POTOK22/STM32-PLC/Documentation/WEBENCH/15Vto5V/WBBOMDesignTPS563200DDCR.csv

Part | Manufacturer | Part Number | Quantity | Price ($) | Footprint (mm²) | Description
Rfbt | Yageo | AC0402FR-0756K2L | 1 | 0.01 | 3 | Resistance: 56.2 kΩ Tolerance: 1.0% Power: 63 mW
Cout | MuRata | GRM21BR61A226ME44L | 2 | 0.09 | 6.75 | Cap: 22 µF Total Derated Cap: 20 µF VDC: 10 V ESR: 3 mΩ Package: 0805
L1 | TDK | VLP8040T-3R3N | 1 | 0.22 | 113.42 | L: 3.3 µH DCR: 20 mΩ IDC: 5.2 A
Rfbb | Vishay-Dale | CRCW040210K0FKED | 1 | 0.01 | 3 | Resistance: 10 kΩ Tolerance: 1.0% Power: 63 mW
Cin | Taiyo Yuden | MSAST219LB5106KTNA01 | 2 | 0.09498 | 6.75 | Cap: 10 µF Total Derated Cap: 2.9 µF VDC: 25 V ESR: 5.85 mΩ Package: 0805
U1 | Texas Instruments | TPS563200DDCR | 1 | 0.342 | 14.82
Cbst | AVX | 08053C104KAT2A | 1 | 0.01 | 6.75 | Cap: 100 nF Total Derated Cap: 100 nF VDC: 25 V ESR: 280 mΩ Package: 0805
