POTOK22/STM32-PLC/Documentation/LTspiceSims/AnalogInSim/analog_input.asc

C1: cap; 100n
D1: zener; EDZV11B
D2: zener; BZX84C6V2L
R1: res; 100k
R2: res; 1k
R3: res; 20.5k
R4: res; 10k
R5: res; 20.5k
R6: res; 10k
U2: LM308
V1: voltage; SINE(0 10 40)
V2: voltage; -15
V3: voltage; 15
V4: voltage; 3.3
Named nets: 0, OUT, IN
.tran 1 startup
