POTOK22/STM32-PLC/Documentation/LTspiceSims/AnalogOutSim/analog_output.asc

C1: cap; 100n
C2: cap; 100n
C3: cap; 100n
C4: cap; 100n
C5: cap; 100n
R1: res; 100k
R2: res; 1k
R3: res; 33k
R4: res; 470
R5: res; 15.4k
R6: res; 10k
U1: LM308
U2: LM308
V1: voltage; SINE(2.465 0.825 40)
V2: voltage; -12
V3: voltage; 12
V4: voltage; 12
V5: voltage; -12
V6: voltage; 5
V7: voltage; SINE(0.825 0.825 40)
Named nets: 0, OUT, IN
.tran 1 startup
