POTOK22/STM32-PLC/Documentation/LTspiceSims/DigitalInSim/digital_input.asc

C1: cap; 1n
C2: cap; 470p
D1: schottky; PMEG3005AEA
D2: LED; NSCW100
M1: pmos; Si7137DP
R1: res; 47k
R2: res; 1k
R3: res; 1k
R4: res; 270k
R5: res; 47k
U1: CNY17-1
V1: voltage; PULSE(0 24 10ms 0.5ms 0.5ms 5ms 10ms)
V2: voltage; 3.3
Named nets: 0, IN, OUT
.tran 100ms startup
