POTOK22/STM32-PLC/Documentation/LTspiceSims/DigitalOutSim/digital_output.asc

D1: LED; NSCW100
M1: nmos; Si7336ADP
R1: res; 1k
R2: res; 1k
R3: res; 47k
R4: res; 220
U1: CNY17-1
V1: voltage; PULSE(0 3.3 10ms 0.5ms 0.5ms 5ms 10ms)
V2: voltage; 3.3
V3: voltage; 24
Named nets: 0, OUT, IN
.tran 100ms startup
