POTOK22/STM32-PLC/Hardware/AnalogIO/analogIO.kicad_pcb

## KiCad design Hardware/AnalogIO/analogIO.kicad_pcb (2026-01-13)

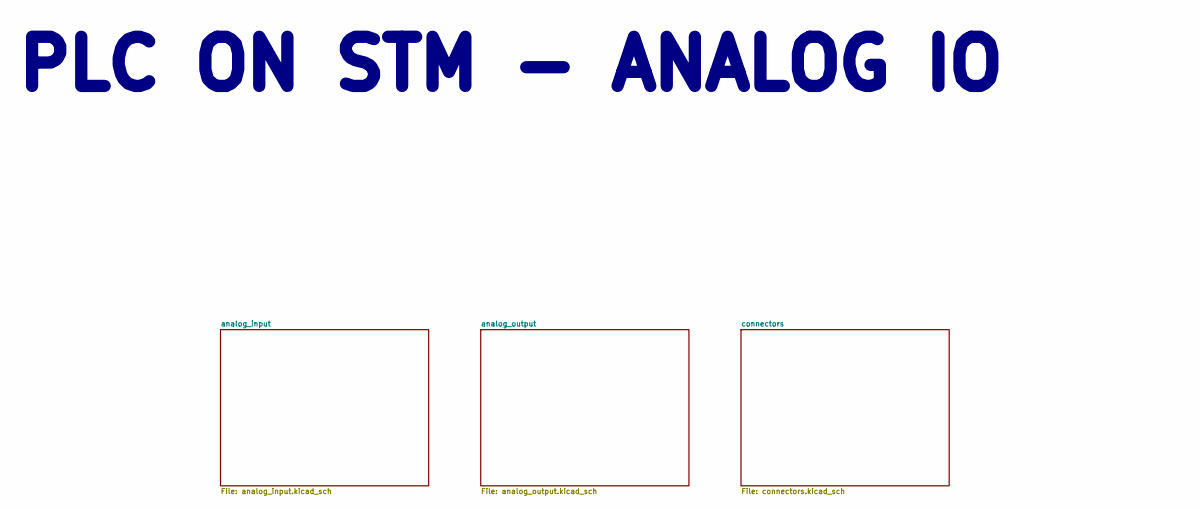
[picture p1: schematic analogIO.kicad_sch, PLC on STM - Analog IO Shield]

Notes on the sheet:
PLC ON STM - ANALOG IO

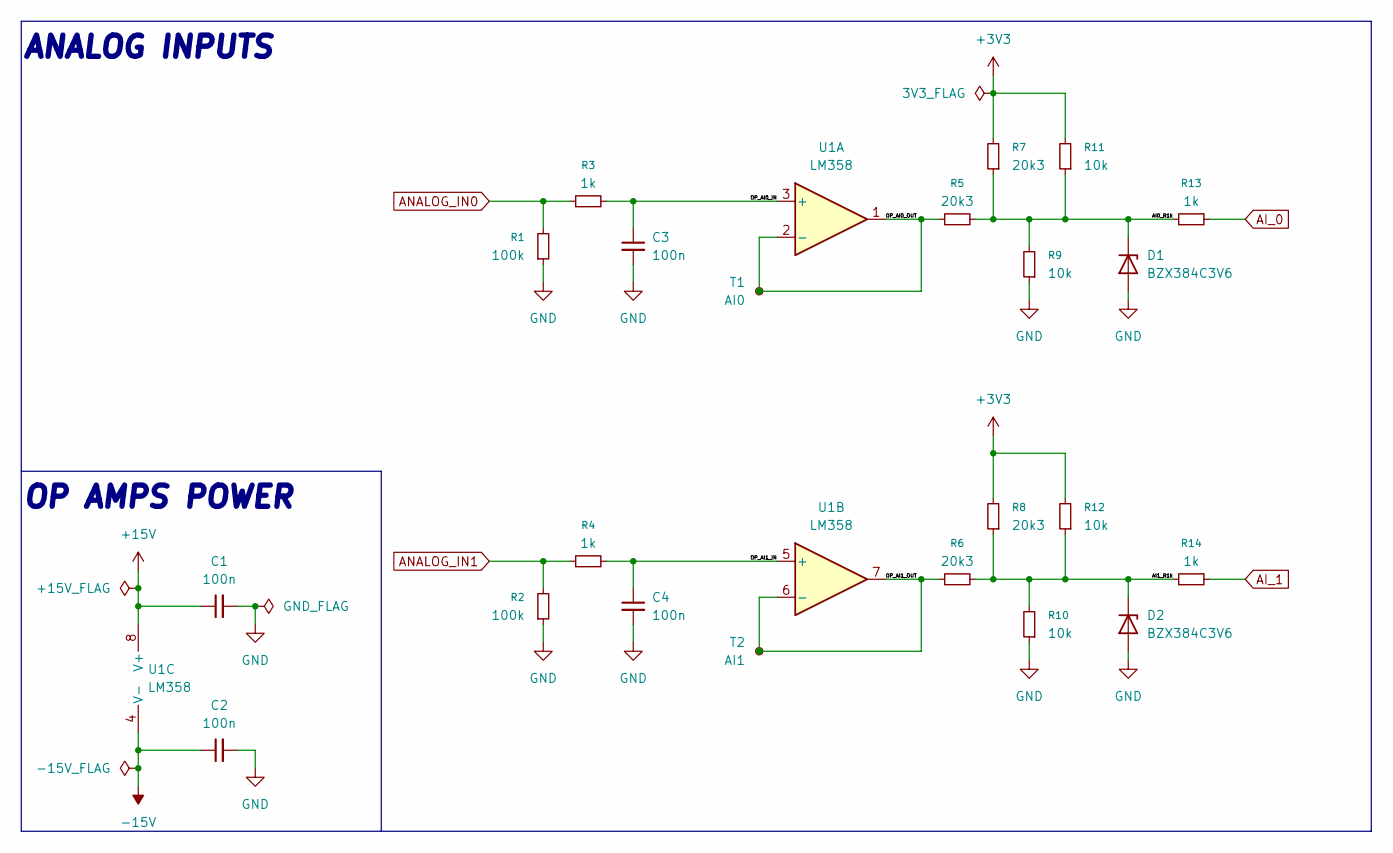
[picture p2: schematic analog_input.kicad_sch, PLC on STM - Analog IO Shield]

Parts:
C1, C2, C3, C4: 100n; C_0603_1608Metric_Pad1.08x0.95mm_HandSolder; Mouser Part Number GRM033R6YA104ME14D
D1, D2: BZX384C3V6; D_SOD-323; Mouser Part Number 78-BZX384C3V6-HE3-08
R1, R2: 100k; R_0603_1608Metric_Pad0.98x0.95mm_HandSolder; Mouser Part Number 603-RT0603DRE07100KL
R3, R4, R13, R14: 1k; R_0603_1608Metric_Pad0.98x0.95mm_HandSolder; Mouser Part Number 71-CRCW06031K00FKED
R5, R6, R7, R8: 20k3; R_0603_1608Metric_Pad0.98x0.95mm_HandSolder; Mouser Part Number 71-CRCW0603-20.5K-E3
R9, R10, R11, R12: 10k; R_0603_1608Metric_Pad0.98x0.95mm_HandSolder; Mouser Part Number 71-CRCW0603-10K-E3
T1: AI0; TestPoint_Pad_1.0x1.0mm
T2: AI1; TestPoint_Pad_1.0x1.0mm
U1: LM358; SOIC-8_3.9x4.9mm_P1.27mm; Mouser Part Number 511-LM358D

Connections:
+3V3: R7.2, R8.2, R11.2, R12.2; also elsewhere on the board
+15V: C1.1, U1.8 (V+); also elsewhere on the board
-15V: C2.1, U1.4 (V-); also elsewhere on the board
/analog_input/AI0_R1k: D1.1 (K), R5.2, R7.1, R9.2, R11.1, R13.1
/analog_input/AI1_R1k: D2.1 (K), R6.2, R8.1, R10.2, R12.1, R14.1
/analog_input/OP_AI0_IN: C3.1, R3.2, U1.3 (+)
/analog_input/OP_AI0_OUT: R5.1, T1.1, U1.1, U1.2 (-)
/analog_input/OP_AI1_IN: C4.1, R4.2, U1.5 (+)
/analog_input/OP_AI1_OUT: R6.1, T2.1, U1.6 (-), U1.7
AI_0: R13.2; also elsewhere on the board
AI_1: R14.2; also elsewhere on the board
ANALOG_IN0: R1.2, R3.1; also elsewhere on the board
ANALOG_IN1: R2.2, R4.1; also elsewhere on the board
GND: C1.2, C2.2, C3.2, C4.2, D1.2 (A), D2.2 (A), R1.1, R2.1, R9.1, R10.1; also elsewhere on the board

Notes on the sheet:
OP AMPS POWER
ANALOG INPUTS

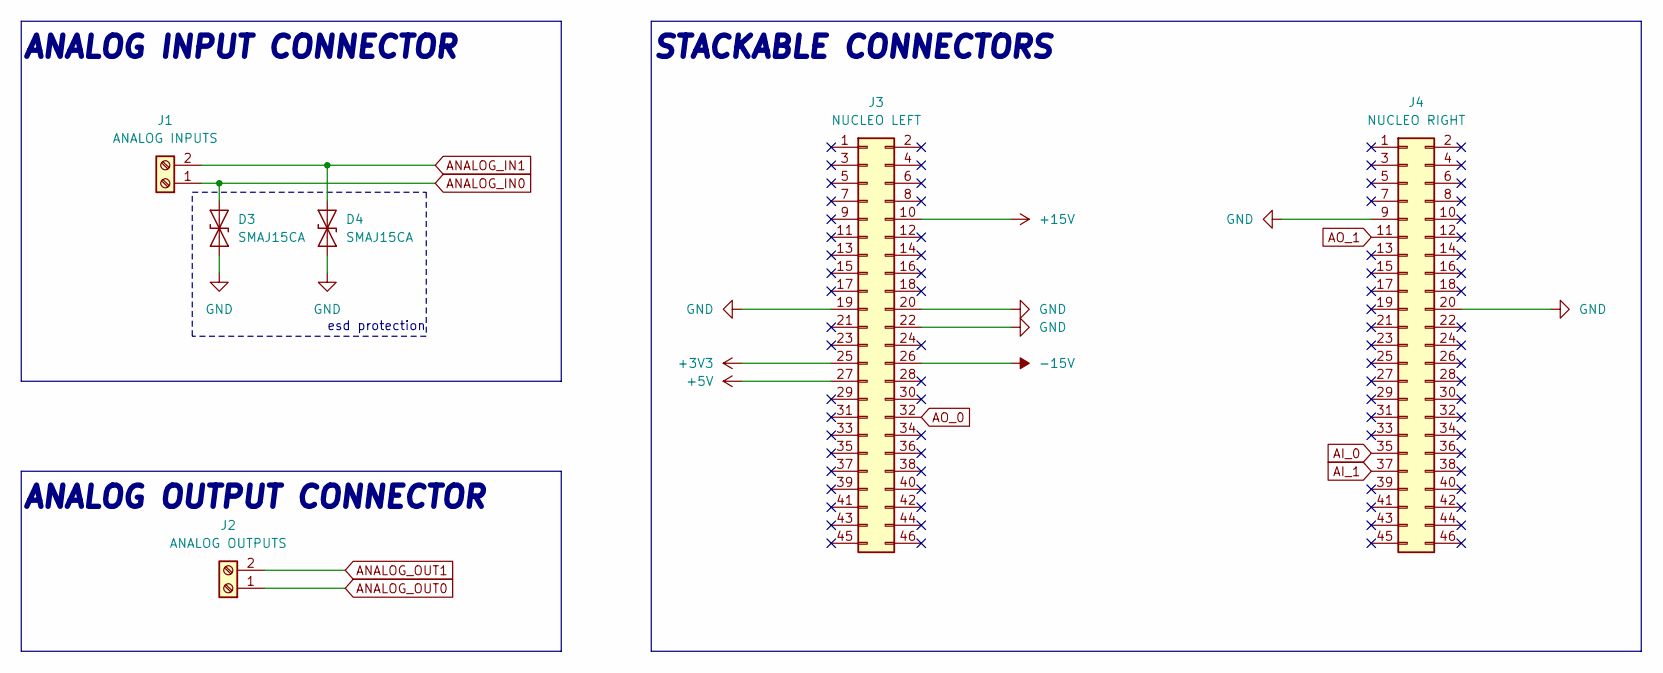
[picture p3: schematic connectors.kicad_sch, PLC on STM - Analog IO Shield]

Parts:
D3, D4: SMAJ15CA; D_SMA; Mouser Part Number 576-SMBJ15CA
J1: ANALOG INPUTS; 1725656; Mouser Part Number 651-1725656
J2: ANALOG OUTPUTS; 1725656; Mouser Part Number 651-1725656
J3: NUCLEO LEFT; PRT12790; Mouser Part Number 474-PRT-12790
J4: NUCLEO RIGHT; PRT12790; Mouser Part Number 474-PRT-12790

Connections:
+3V3: J3.25; also elsewhere on the board
+5V: J3.27; also elsewhere on the board
+15V: J3.10; also elsewhere on the board
-15V: J3.26; also elsewhere on the board
AI_0: J4.35; also elsewhere on the board
AI_1: J4.37; also elsewhere on the board
ANALOG_IN0: D3.2 (A2), J1.1; also elsewhere on the board
ANALOG_IN1: D4.2 (A2), J1.2; also elsewhere on the board
ANALOG_OUT0: J2.1; also elsewhere on the board
ANALOG_OUT1: J2.2; also elsewhere on the board
AO_0: J3.32; also elsewhere on the board
AO_1: J4.11; also elsewhere on the board
GND: D3.1 (A1), D4.1 (A1), J3.19, J3.20, J3.22, J4.9, J4.20; also elsewhere on the board

Notes on the sheet:
ANALOG INPUT CONNECTOR
STACKABLE CONNECTORS
esd protection
ANALOG OUTPUT CONNECTOR

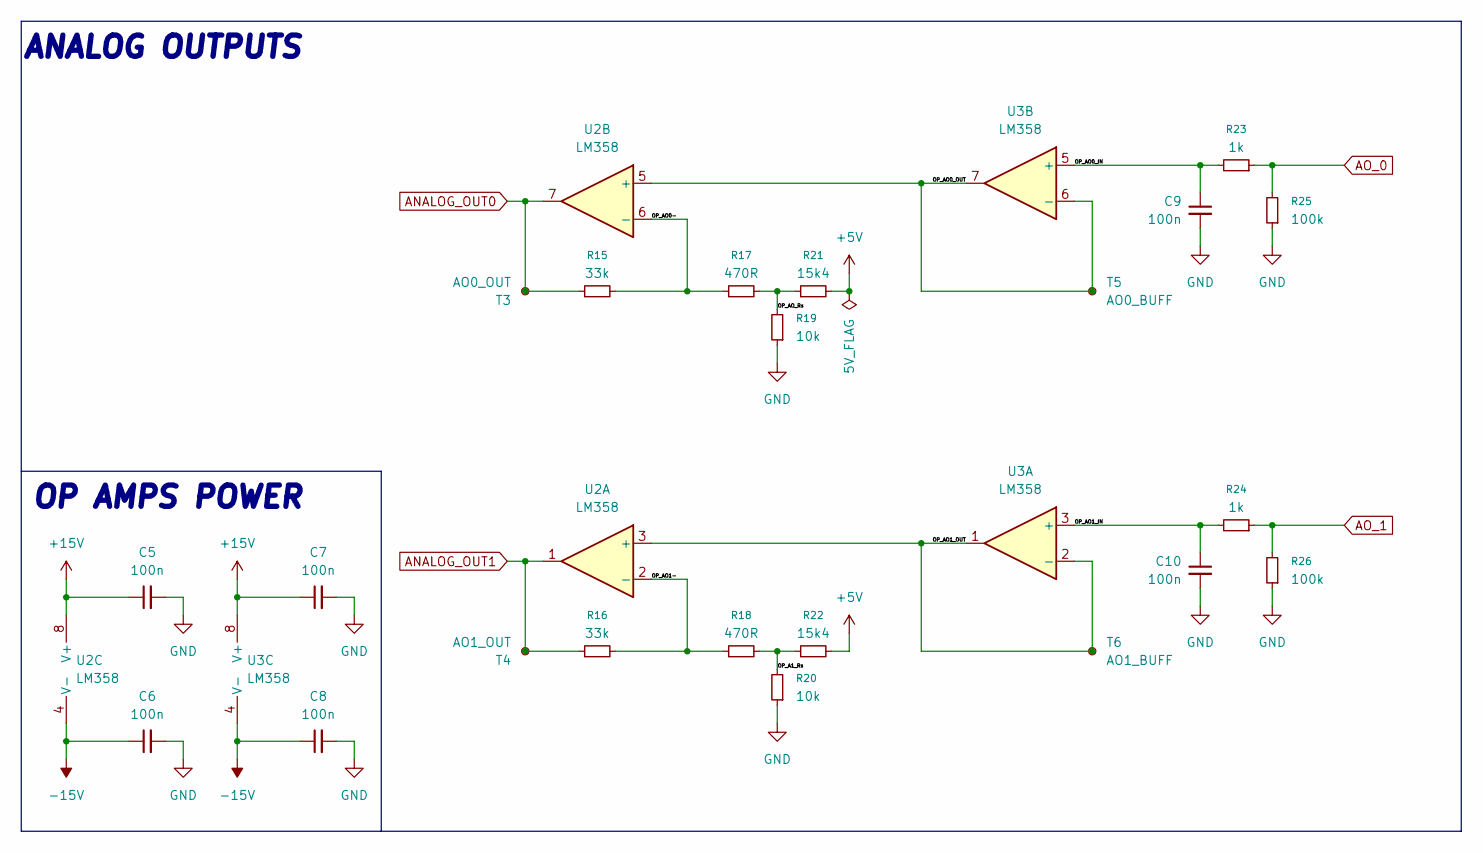
[picture p4: schematic analog_output.kicad_sch, PLC on STM - Analog IO Shield]

Parts:
C5, C6, C7, C8, C9, C10: 100n; C_0603_1608Metric_Pad1.08x0.95mm_HandSolder; Mouser Part Number GRM033R6YA104ME14D
R15, R16: 33k; R_0603_1608Metric_Pad0.98x0.95mm_HandSolder; Mouser Part Number 71-CRCW0603-33K-E3
R17, R18: 470R; R_0603_1608Metric_Pad0.98x0.95mm_HandSolder; Mouser Part Number 71-CRCW0603-470-E3
R19, R20: 10k; R_0603_1608Metric_Pad0.98x0.95mm_HandSolder; Mouser Part Number 71-CRCW0603-10K-E3
R21, R22: 15k4; R_0603_1608Metric_Pad0.98x0.95mm_HandSolder; Mouser Part Number 71-CRCW0603-15.4K-E3
R23, R24: 1k; R_0603_1608Metric_Pad0.98x0.95mm_HandSolder; Mouser Part Number 71-CRCW06031K00FKED
R25, R26: 100k; R_0603_1608Metric_Pad0.98x0.95mm_HandSolder; Mouser Part Number 603-RT0603DRE07100KL
T3: AO0_OUT; TestPoint_Pad_1.0x1.0mm
T4: AO1_OUT; TestPoint_Pad_1.0x1.0mm
T5: AO0_BUFF; TestPoint_Pad_1.0x1.0mm
T6: AO1_BUFF; TestPoint_Pad_1.0x1.0mm
U2, U3: LM358; SOIC-8_3.9x4.9mm_P1.27mm; Mouser Part Number 511-LM358D

Connections:
+5V: R21.2, R22.2; also elsewhere on the board
+15V: C5.1, C7.1, U2.8 (V+), U3.8 (V+); also elsewhere on the board
-15V: C6.1, C8.1, U2.4 (V-), U3.4 (V-); also elsewhere on the board
/analog_output/OP_A1_Rs: R18.2, R20.2, R22.1
/analog_output/OP_AO0-: R15.2, R17.1, U2.6 (-)
/analog_output/OP_AO0_IN: C9.1, R23.2, U3.5 (+)
/analog_output/OP_AO0_OUT: T5.1, U2.5 (+), U3.6 (-), U3.7
/analog_output/OP_AO1-: R16.2, R18.1, U2.2 (-)
/analog_output/OP_AO1_IN: C10.1, R24.2, U3.3 (+)
/analog_output/OP_AO1_OUT: T6.1, U2.3 (+), U3.1, U3.2 (-)
/analog_output/OP_AO_Rs: R17.2, R19.2, R21.1
ANALOG_OUT0: R15.1, T3.1, U2.7; also elsewhere on the board
ANALOG_OUT1: R16.1, T4.1, U2.1; also elsewhere on the board
AO_0: R23.1, R25.2; also elsewhere on the board
AO_1: R24.1, R26.2; also elsewhere on the board
GND: C5.2, C6.2, C7.2, C8.2, C9.2, C10.2, R19.1, R20.1, R25.1, R26.1; also elsewhere on the board

Notes on the sheet:
ANALOG OUTPUTS
OP AMPS POWER

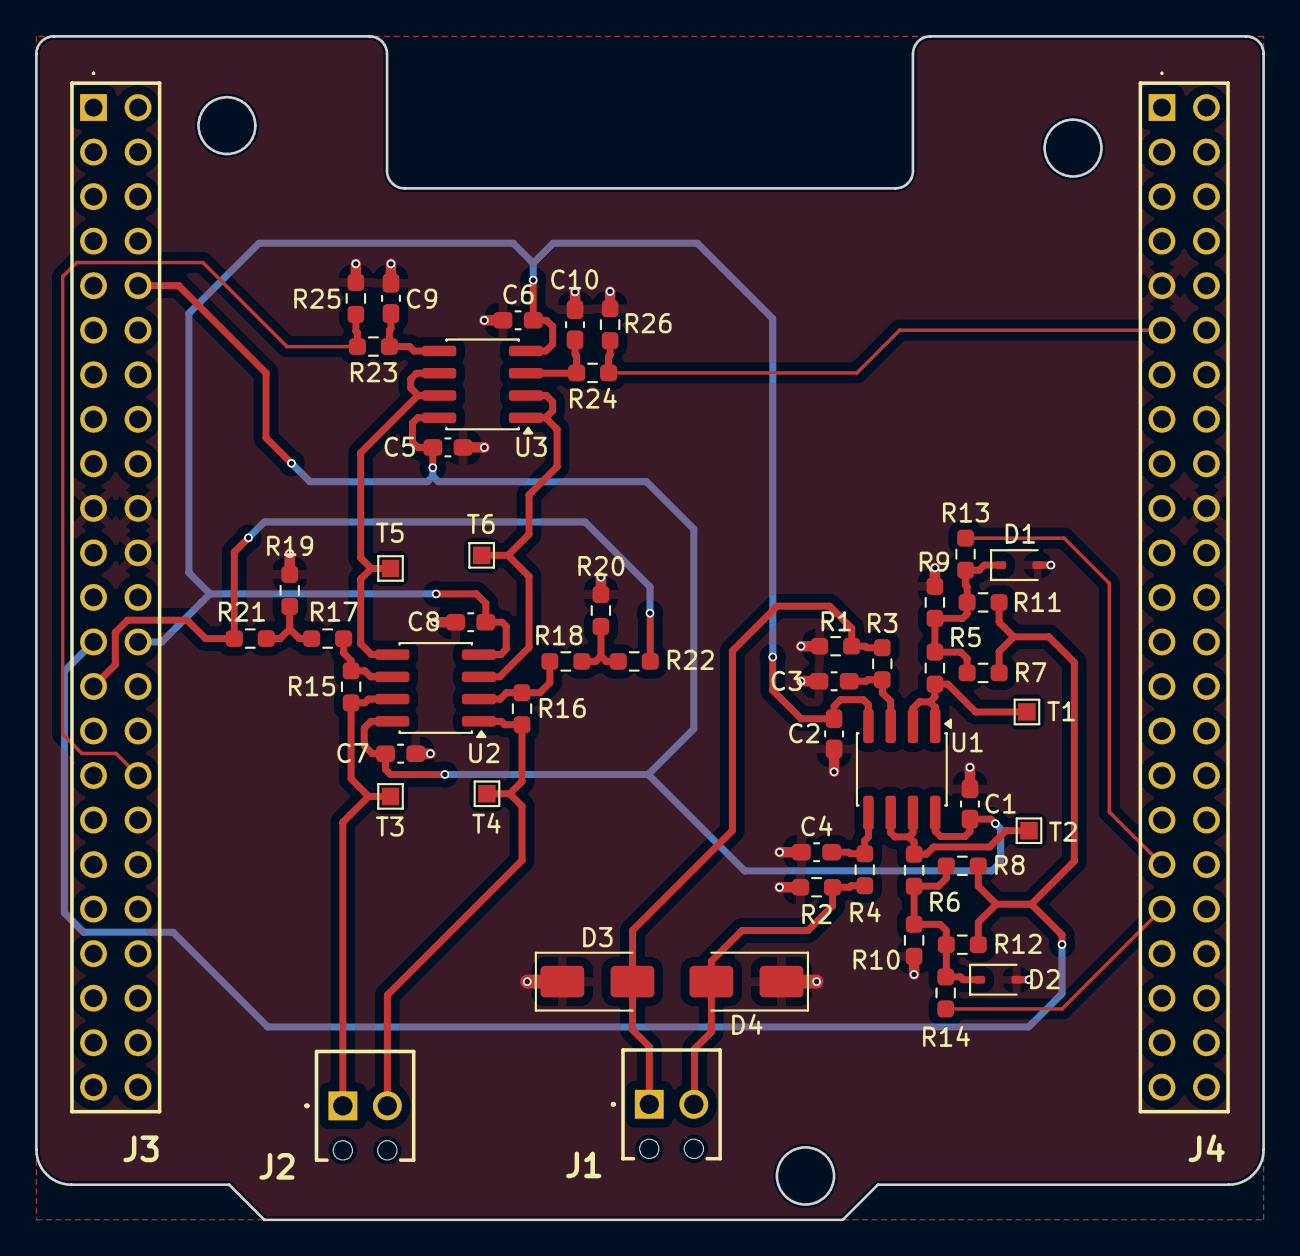
[picture p5: board analogIO.kicad_pcb from above]

Board: 4 copper layers, 70.0 x 67.5 mm, 53 parts (0 on the bottom side), 27 nets.
