POTOK22/STM32-PLC/Hardware/Power/power.kicad_pcb

## KiCad design Hardware/Power/power.kicad_pcb (2026-01-13)

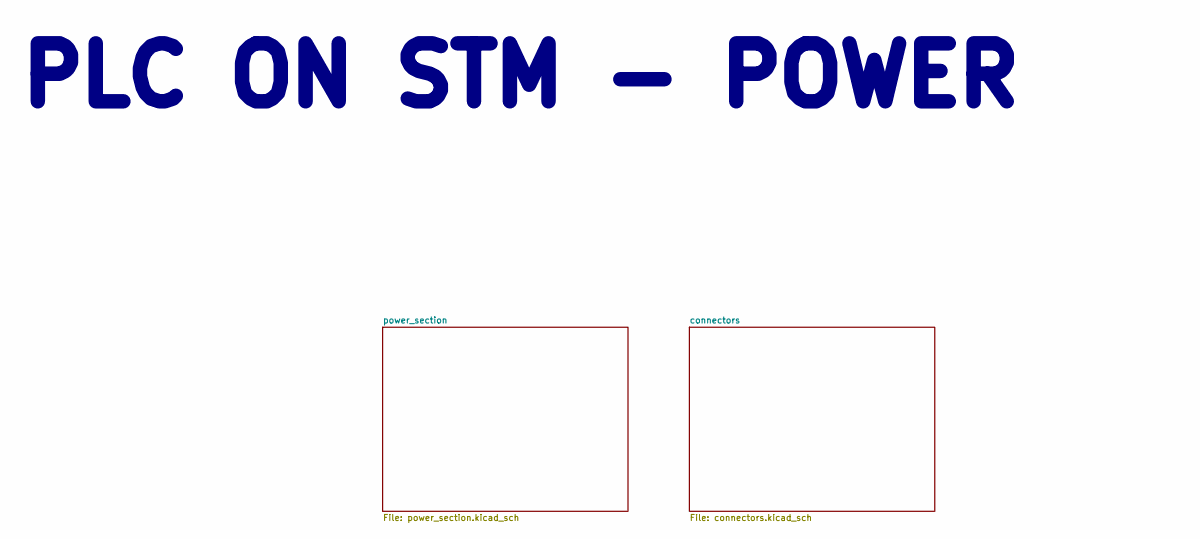
[picture p6: schematic power.kicad_sch, PLC on STM - Power Shield]

Notes on the sheet:
PLC ON STM - POWER

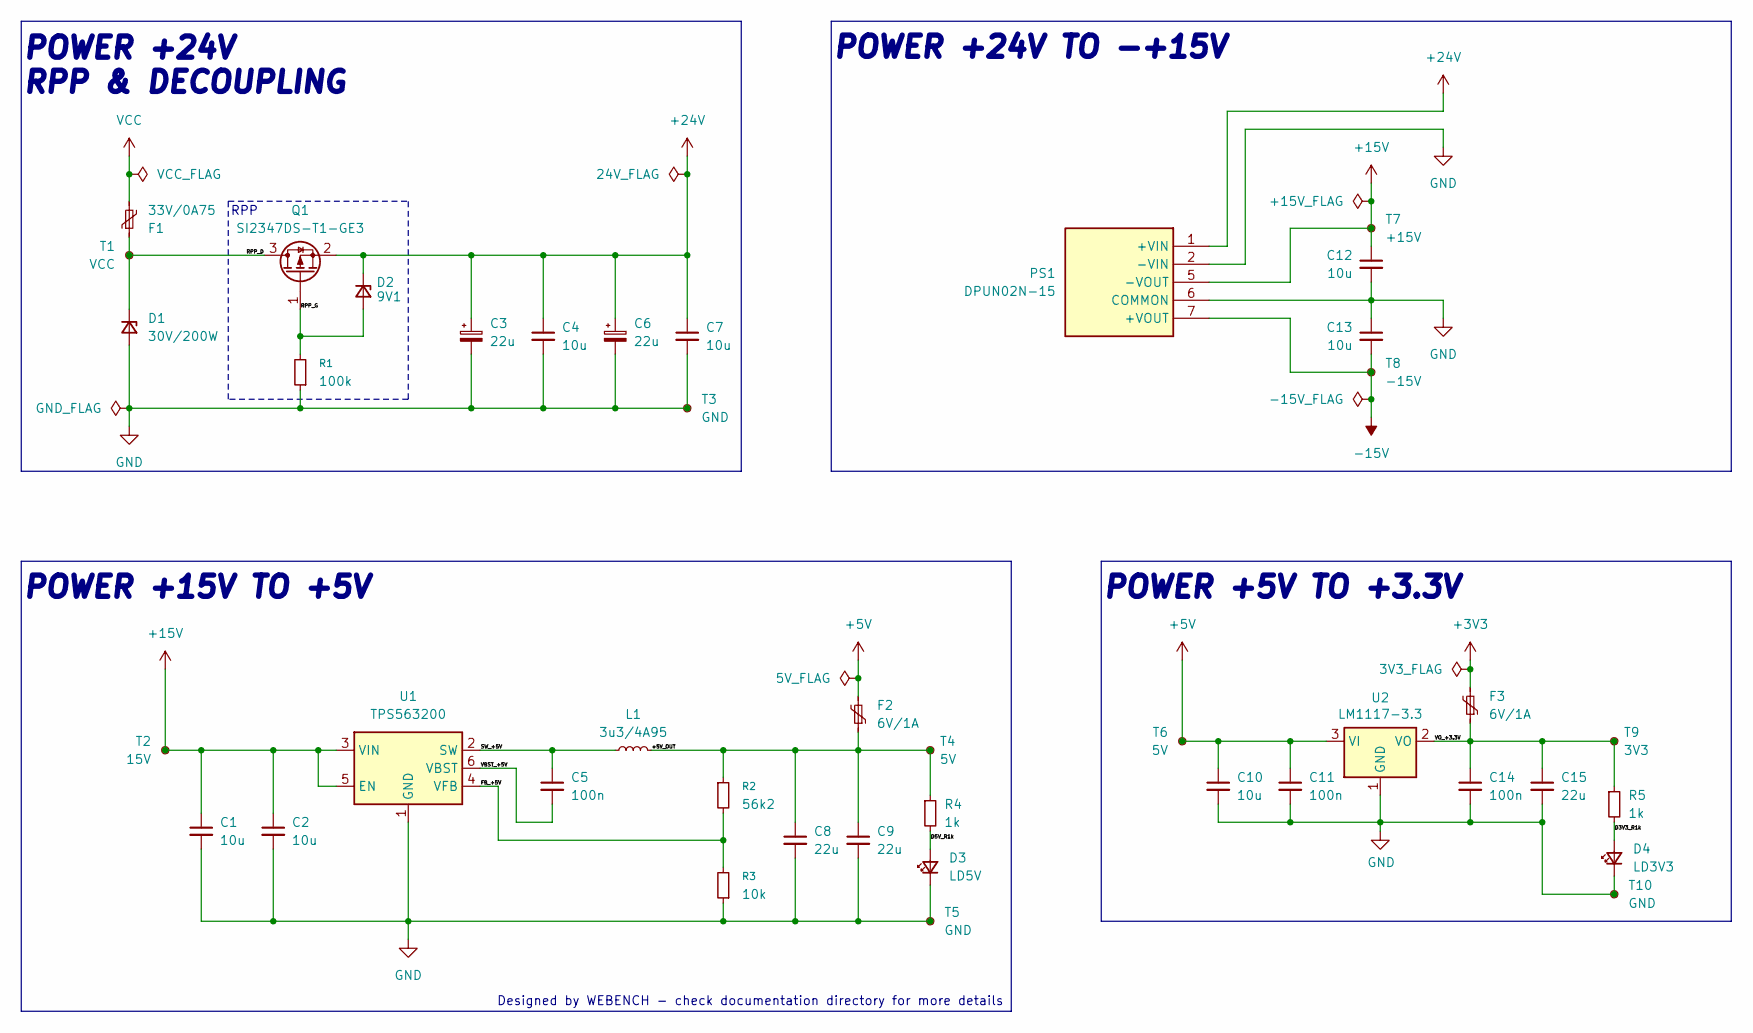
[picture p7: schematic power_section.kicad_sch, PLC on STM - Power Shield]

Parts:
C1, C2, C4, C7, C10, C12, C13: 10u; C_0603_1608Metric_Pad1.08x0.95mm_HandSolder; Mouser Part Number 81-GRM188R6YA106MA3J
C3, C6: 22u; CP_Elec_4x5.8; Mouser Part Number 647-UCM1V220MCL1GS
C5, C11, C14: 100n; C_0603_1608Metric_Pad1.08x0.95mm_HandSolder; Mouser Part Number GRM033R6YA104ME14D
C8, C9, C15: 22u; C_0603_1608Metric_Pad1.08x0.95mm_HandSolder; Mouser Part Number 810-C2012X5R1V226MAC
D1: 30V/200W; D_SOD-123; Mouser Part Number 750-TV02W260-G
D2: 9V1; D_SOD-323_HandSoldering; Mouser Part Number 833-MMXZ5239B-TP
D3: LD5V; LED_0603_1608Metric_Pad1.05x0.95mm_HandSolder
D4: LD3V3; LED_0603_1608Metric_Pad1.05x0.95mm_HandSolder
F1: 33V/0A75; Fuse_2920_7451Metric_Pad2.10x5.45mm_HandSolder; Mouser Part Number 530-0ZCF0075AF2C
F2, F3: 6V/1A; Fuse_0805_2012Metric_Pad1.15x1.40mm_HandSolder; Mouser Part Number 650-PICOSMDC050S-2
L1: 3u3/4A95; L_TDK_VLS6045EX_VLS6045AF; Mouser Part Number 810-VLS6045EX-3R3N
PS1: DPUN02N-15; DPUN02N15; Mouser Part Number 709-DPUN02N-15
Q1: SI2347DS-T1-GE3; SOT-23-3; Mouser Part Number 78-SI2347DS-T1-GE3
R1: 100k; R_0603_1608Metric_Pad0.98x0.95mm_HandSolder; Mouser Part Number 603-RT0603DRE07100KL
R2: 56k2; R_0603_1608Metric_Pad0.98x0.95mm_HandSolder; Mouser Part Number 71-CRCW060356K2FKEAH
R3: 10k; R_0603_1608Metric_Pad0.98x0.95mm_HandSolder; Mouser Part Number 71-CRCW0603-10K-E3
R4, R5: 1k; R_0603_1608Metric_Pad0.98x0.95mm_HandSolder; Mouser Part Number 71-CRCW06031K00FKED
T1: VCC; TestPoint_Pad_1.0x1.0mm
T2: 15V; TestPoint_Pad_1.0x1.0mm
T3, T5, T10: GND; TestPoint_Pad_1.0x1.0mm
T4, T6: 5V; TestPoint_Pad_1.0x1.0mm
T7: +15V; TestPoint_Pad_1.0x1.0mm
T8: -15V; TestPoint_Pad_1.0x1.0mm
T9: 3V3; TestPoint_Pad_1.0x1.0mm
U1: TPS563200; SOT-23-6; Mouser Part Number 595-TPS563200DDCR
U2: LM1117-3.3; SOT-223-3_TabPin2; Mouser Part Number 926-LM1117MPX3.3NOPB

Connections:
+3V3: F3.2; also elsewhere on the board
+5V: C10.1, C11.1, F2.2, T6.1, U2.3 (VI); also elsewhere on the board
+15V: C1.1, C2.1, C12.1, PS1.5 (-VOUT), T2.1, T7.1, U1.3 (VIN), U1.5 (EN); also elsewhere on the board
+24V: C3.1, C4.1, C6.1, C7.1, D2.1 (K), PS1.1 (+VIN), Q1.2 (S); also elsewhere on the board
-15V: C13.2, PS1.7 (+VOUT), T8.1; also elsewhere on the board
/power_section/+5V_OUT: C8.1, C9.1, F2.1, L1.2, R2.1, R4.1, T4.1
/power_section/D3V3_R1k: D4.2 (A), R5.2
/power_section/D5V_R1k: D3.2 (A), R4.2
/power_section/FB_+5V: R2.2, R3.2, U1.4 (VFB)
/power_section/RPP_D: D1.1 (K), F1.1, Q1.3 (D), T1.1
/power_section/RPP_G: D2.2 (A), Q1.1 (G), R1.2
/power_section/SW_+5V: C5.1, L1.1, U1.2 (SW)
/power_section/VBST_+5V: C5.2, U1.6 (VBST)
/power_section/VO_+3.3V: C14.1, C15.1, F3.1, R5.1, T9.1, U2.2 (VO)
GND: C1.2, C2.2, C3.2, C4.2, C6.2, C7.2, C8.2, C9.2, C10.2, C11.2, C12.2, C13.1, C14.2, C15.2, D1.2 (A), D3.1 (K), D4.1 (K), PS1.2 (-VIN), PS1.6 (COMMON), R1.1, R3.1, T3.1, T5.1, T10.1, U1.1 (GND), U2.1 (GND); also elsewhere on the board
VCC: F1.2; also elsewhere on the board

Notes on the sheet:
POWER +24V TO -+15V
POWER +15V TO +5V
RPP
POWER +24V RPP & DECOUPLING
POWER +5V TO +3.3V
Designed by WEBENCH - check documentation directory for more details

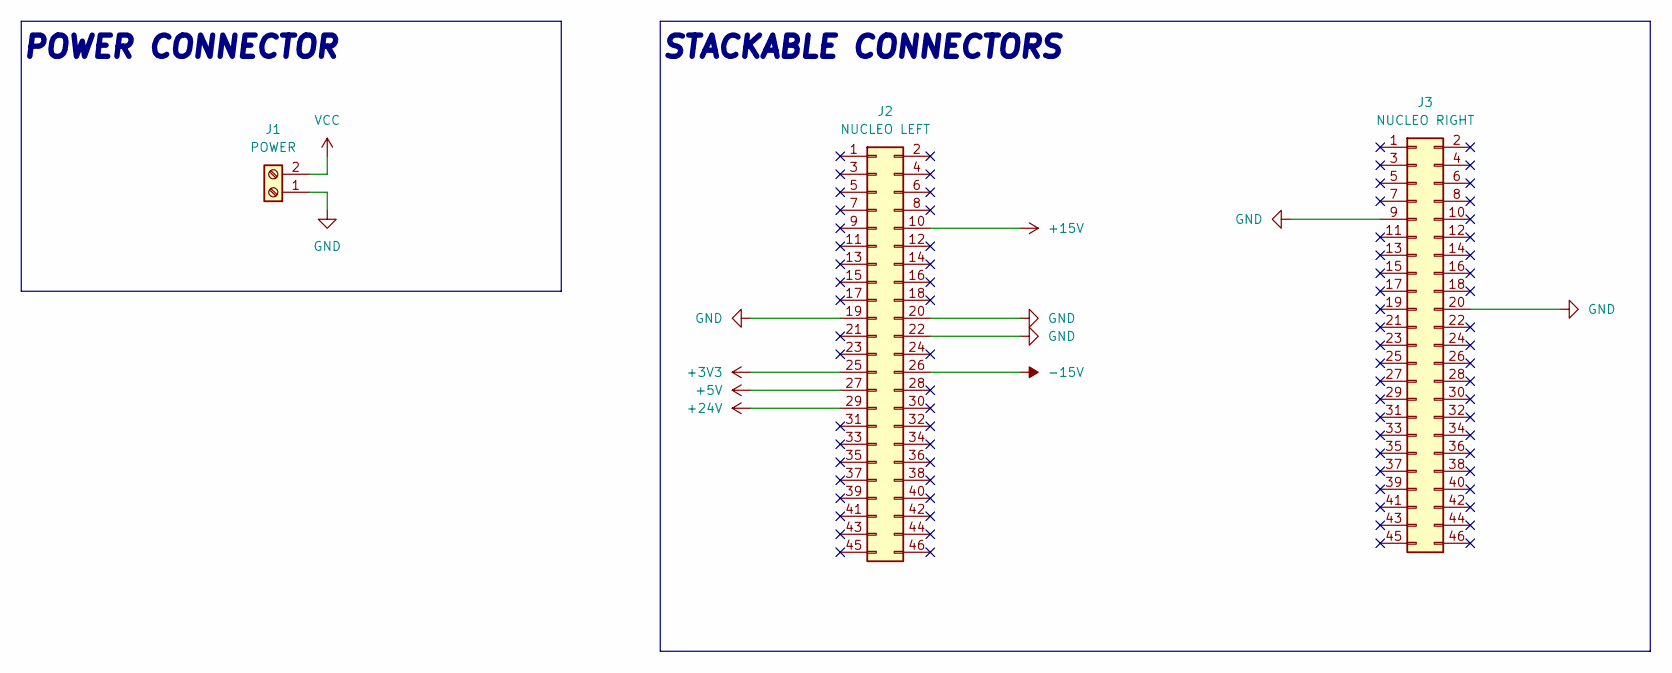
[picture p8: schematic connectors.kicad_sch, PLC on STM - Power Shield]

Parts:
J1: POWER; 1725656; Mouser Part Number 651-1725656
J2: NUCLEO LEFT; PRT12790; Mouser Part Number 474-PRT-12790
J3: NUCLEO RIGHT; PRT12790; Mouser Part Number 474-PRT-12790

Connections:
+3V3: J2.25; also elsewhere on the board
+5V: J2.27; also elsewhere on the board
+15V: J2.10; also elsewhere on the board
+24V: J2.29; also elsewhere on the board
-15V: J2.26; also elsewhere on the board
GND: J1.1, J2.19, J2.20, J2.22, J3.9, J3.20; also elsewhere on the board
VCC: J1.2; also elsewhere on the board

Notes on the sheet:
POWER CONNECTOR
STACKABLE CONNECTORS

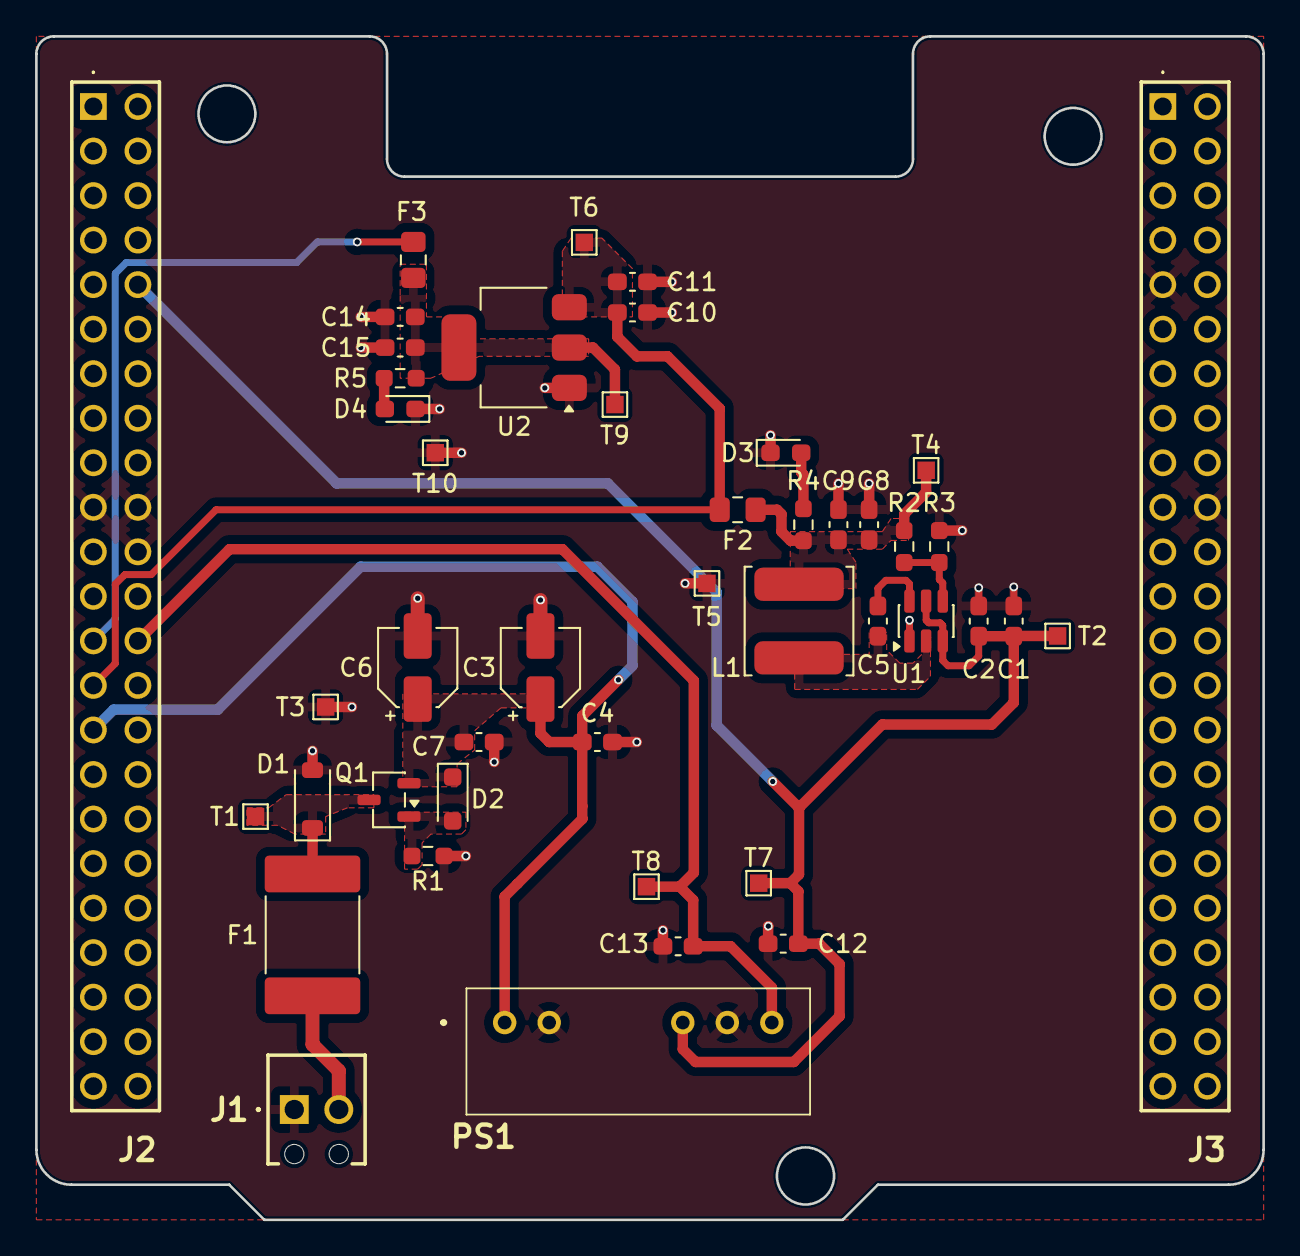
[picture p9: board power.kicad_pcb from above]

Board: 4 copper layers, 70.0 x 67.5 mm, 45 parts (0 on the bottom side), 16 nets.
