POTOK22/STM32-PLC/Hardware/CAN_UART/can_uart.kicad_pcb

## KiCad design Hardware/CAN_UART/can_uart.kicad_pcb (2026-01-13)

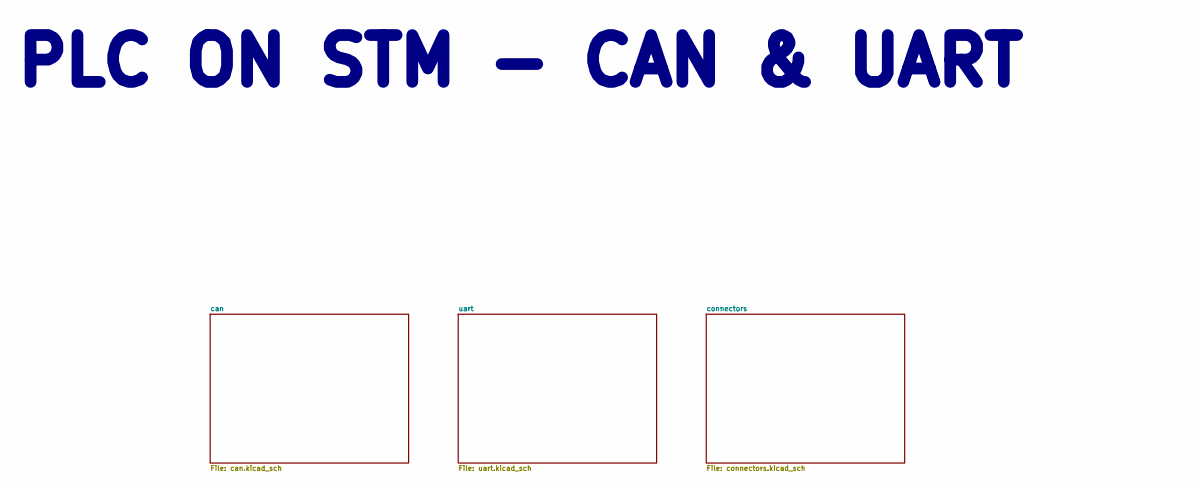
[picture p10: schematic can_uart.kicad_sch, PLC on STM - CAN & UART Shield]

Notes on the sheet:
PLC ON STM - CAN & UART

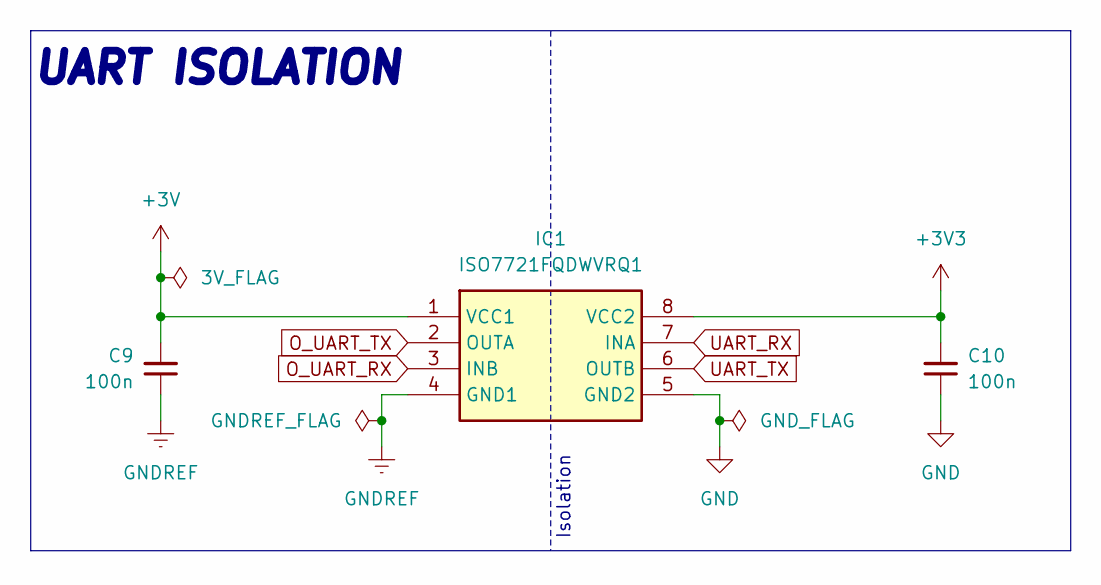
[picture p11: schematic uart.kicad_sch, PLC on STM - CAN & UART Shield]

Parts:
C9, C10: 100n; C_0603_1608Metric_Pad1.08x0.95mm_HandSolder; Mouser Part Number GRM033R6YA104ME14D
IC1: ISO7721FQDWVRQ1; SOIC127P1150X280-8N; Manufacturer_Part_Number ISO7721FQDWVRQ1

Connections:
+3V: C9.2, IC1.1 (VCC1); also elsewhere on the board
+3V3: C10.2, IC1.8 (VCC2); also elsewhere on the board
GND: C10.1, IC1.5 (GND2); also elsewhere on the board
GNDREF: C9.1, IC1.4 (GND1); also elsewhere on the board
O_UART_RX: IC1.3 (INB); also elsewhere on the board
O_UART_TX: IC1.2 (OUTA); also elsewhere on the board
UART_RX: IC1.7 (INA); also elsewhere on the board
UART_TX: IC1.6 (OUTB); also elsewhere on the board

Notes on the sheet:
Isolation
UART ISOLATION

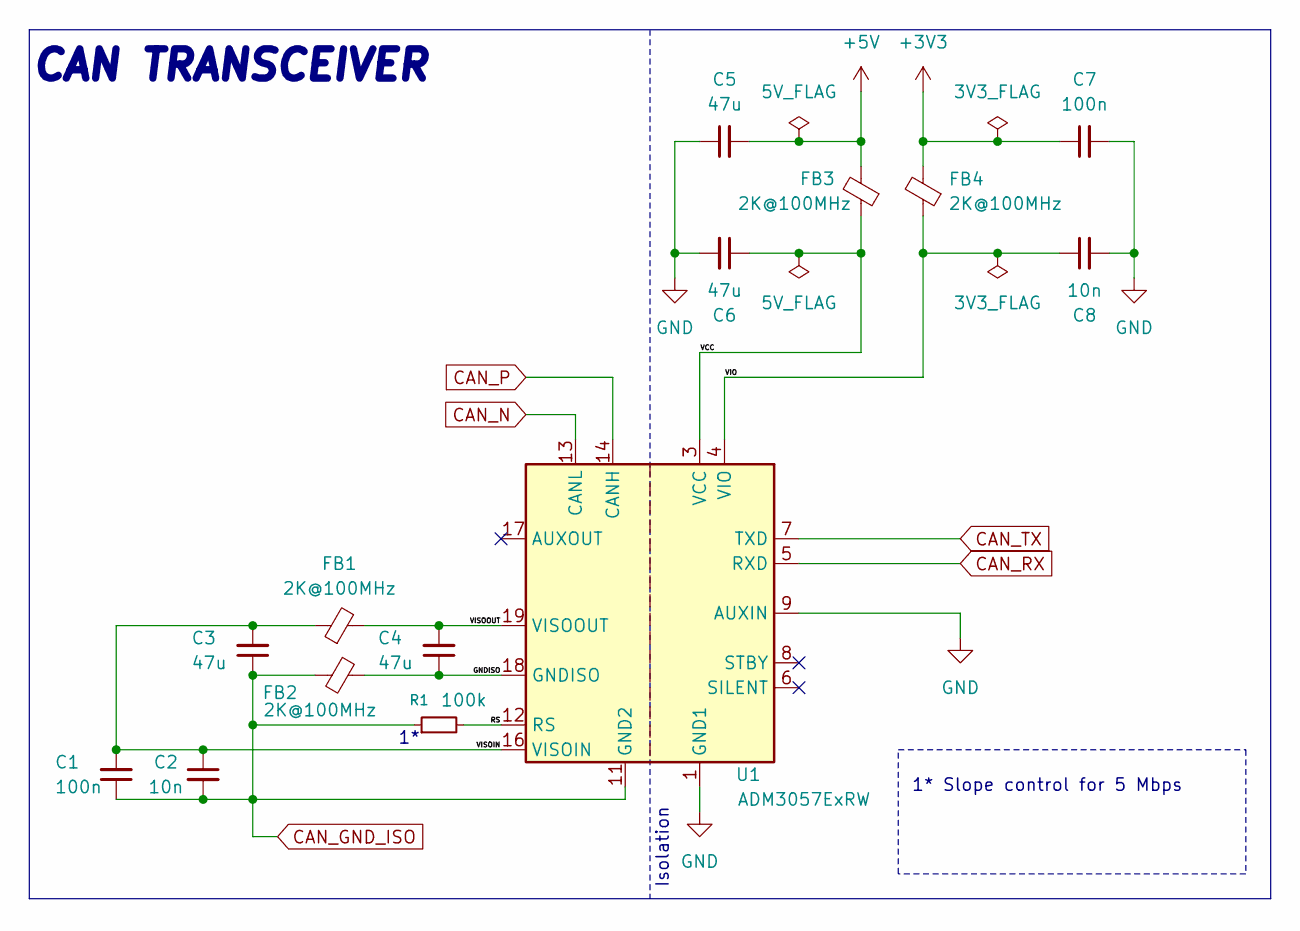
[picture p12: schematic can.kicad_sch, PLC on STM - CAN & UART Shield]

Parts:
C1, C7: 100n; C_0603_1608Metric_Pad1.08x0.95mm_HandSolder; Mouser Part Number GRM033R6YA104ME14D
C2, C8: 10n; C_0603_1608Metric_Pad1.08x0.95mm_HandSolder; Mouser Part Number 81-GRM1857U1A103JA4J
C3, C4, C5, C6: 47u; C_0805_2012Metric_Pad1.18x1.45mm_HandSolder; Mouser Part Number 81-GRM21BR60J476M01L
FB1, FB2, FB3, FB4: 2K@100MHz; L_0805_2012Metric_Pad1.05x1.20mm_HandSolder; Mouser Part Number 623-2508052027Y1
R1: 100k; R_0603_1608Metric_Pad0.98x0.95mm_HandSolder; Mouser Part Number 603-RT0603DRE07100KL
U1: ADM3057ExRW; SOIC-20W_7.5x12.8mm_P1.27mm; Mouser Part Number 584-ADM3057ETRWZ-EP

Connections:
+3V3: C7.1, FB4.2; also elsewhere on the board
+5V: C5.2, FB3.2; also elsewhere on the board
/can/GNDISO: C4.1, FB2.1, U1.18 (GNDISO), U1.20 (GNDISO)
/can/RS: R1.2, U1.12 (RS)
/can/VCC: C6.1, FB3.1, U1.3 (VCC)
/can/VIO: C8.1, FB4.1, U1.4 (VIO)
/can/VISOIN: C1.2, C2.1, C3.2, FB1.1, U1.16 (VISOIN)
/can/VISOOUT: C4.2, FB1.2, U1.19 (VISOOUT)
CAN_GND_ISO: C1.1, C2.2, C3.1, FB2.2, R1.1, U1.11 (GND2), U1.15 (GND2); also elsewhere on the board
CAN_N: U1.13 (CANL); also elsewhere on the board
CAN_P: U1.14 (CANH); also elsewhere on the board
CAN_RX: U1.5 (RXD); also elsewhere on the board
CAN_TX: U1.7 (TXD); also elsewhere on the board
GND: C5.1, C6.2, C7.2, C8.2, U1.1 (GND1), U1.2 (GND1), U1.9 (AUXIN), U1.10 (GND1); also elsewhere on the board

Notes on the sheet:
Isolation
CAN TRANSCEIVER
1* Slope control for 5 Mbps

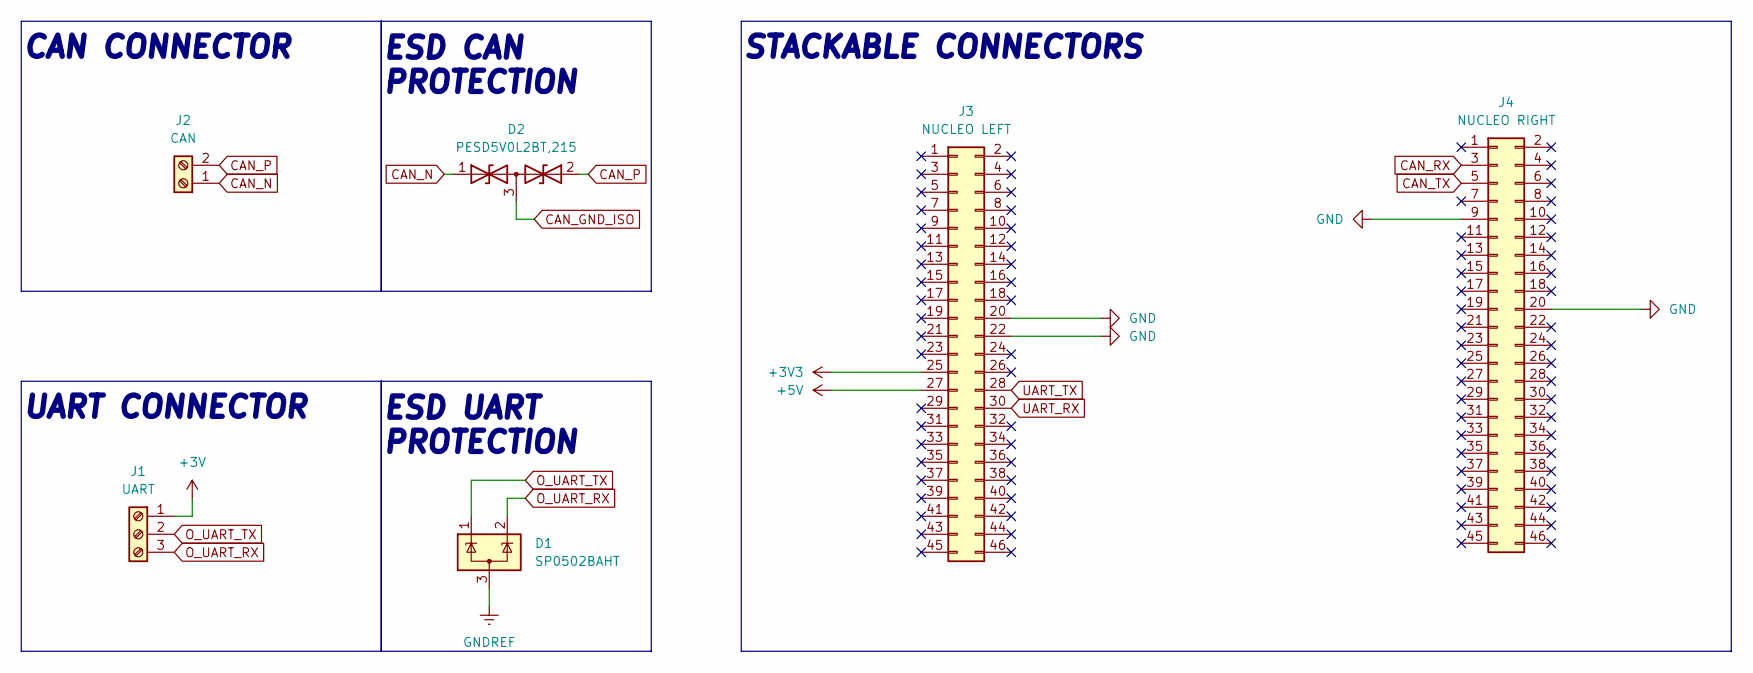
[picture p13: schematic connectors.kicad_sch, PLC on STM - CAN & UART Shield]

Parts:
D1: SP0502BAHT; SOT-23
D2: PESD5V0L2BT,215; SOT-23-3; Mouser Part Number 771-PESD5V0L2BT-T/R
J1: UART; 1725669
J2: CAN; 1725656; Mouser Part Number 651-1725656
J3: NUCLEO LEFT; PRT12790; Mouser Part Number 474-PRT-12790
J4: NUCLEO RIGHT; PRT12790; Mouser Part Number 474-PRT-12790

Connections:
+3V: J1.1; also elsewhere on the board
+3V3: J3.25; also elsewhere on the board
+5V: J3.27; also elsewhere on the board
CAN_GND_ISO: D2.3 (common); also elsewhere on the board
CAN_N: D2.1 (A1), J2.1; also elsewhere on the board
CAN_P: D2.2 (A2), J2.2; also elsewhere on the board
CAN_RX: J4.3; also elsewhere on the board
CAN_TX: J4.5; also elsewhere on the board
GND: J3.20, J3.22, J4.9, J4.20; also elsewhere on the board
GNDREF: D1.3 (A); also elsewhere on the board
O_UART_RX: D1.2 (K), J1.3; also elsewhere on the board
O_UART_TX: D1.1 (K), J1.2; also elsewhere on the board
UART_RX: J3.30; also elsewhere on the board
UART_TX: J3.28; also elsewhere on the board

Notes on the sheet:
UART CONNECTOR
CAN CONNECTOR
ESD UART PROTECTION
ESD CAN PROTECTION
STACKABLE CONNECTORS
