POTOK22/STM32-PLC/Hardware/CAN_UART/can_uart.kicad_pcb

## KiCad design Hardware/CAN_UART/can_uart.kicad_pcb (continued)

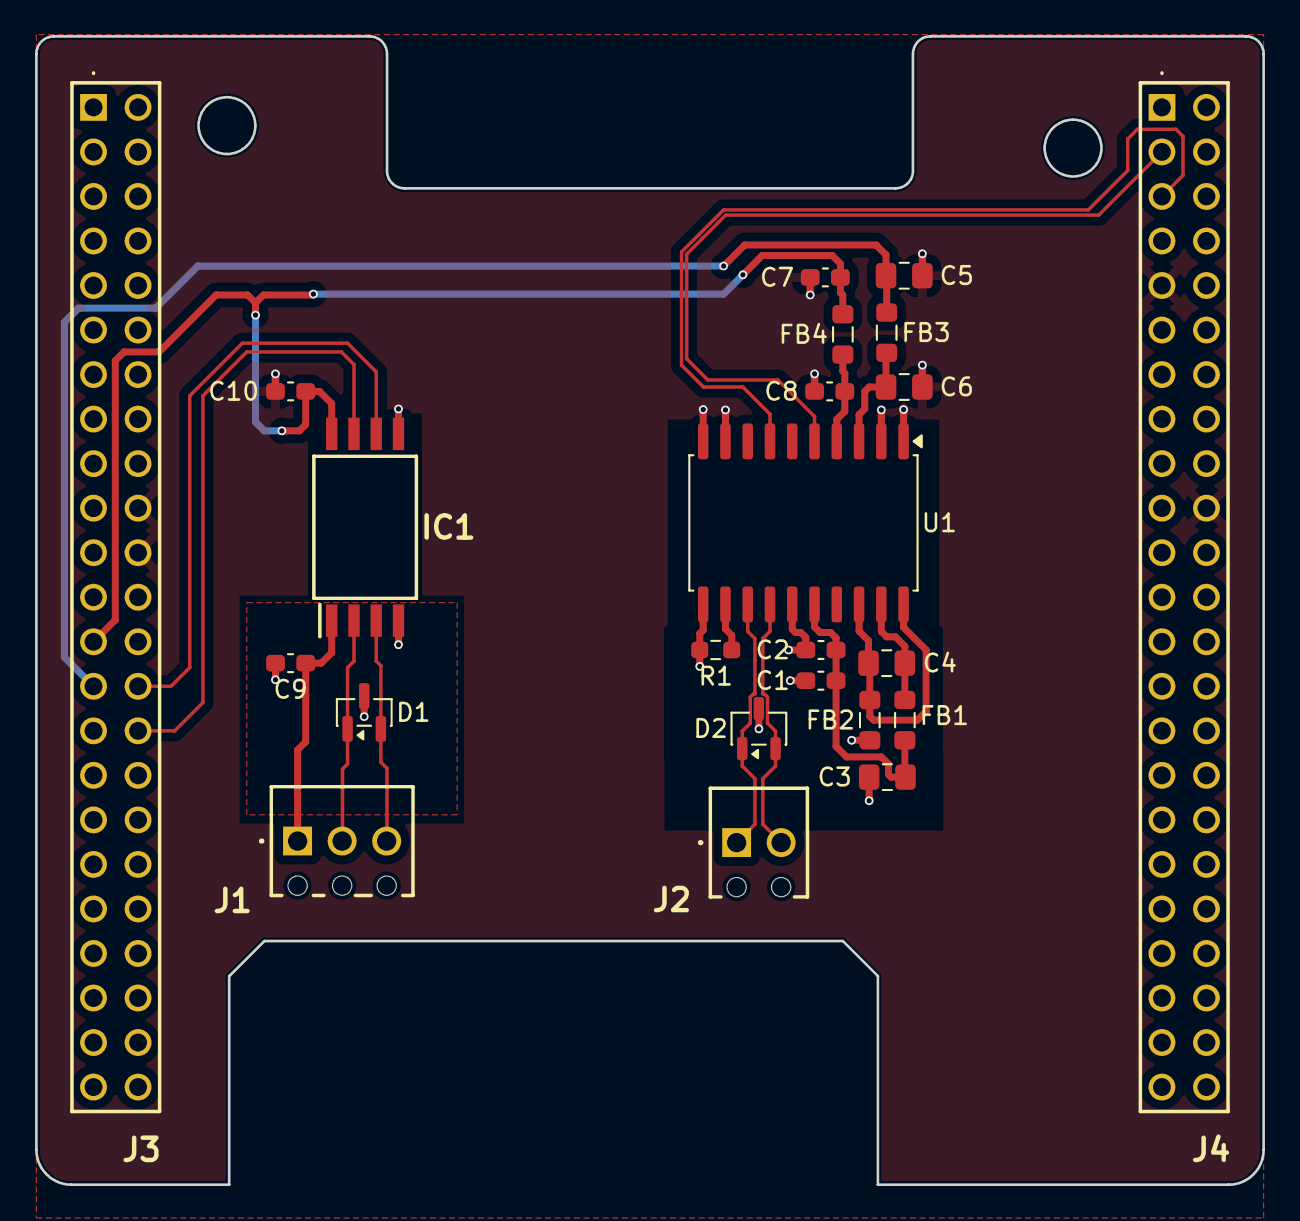
[picture p14: board can_uart.kicad_pcb from above]

Board: 4 copper layers, 70.0 x 65.5 mm, 23 parts (0 on the bottom side), 20 nets.
