POTOK22/STM32-PLC/Hardware/DigitalInput/digital_input.kicad_pcb

## KiCad design Hardware/DigitalInput/digital_input.kicad_pcb (2026-01-13)

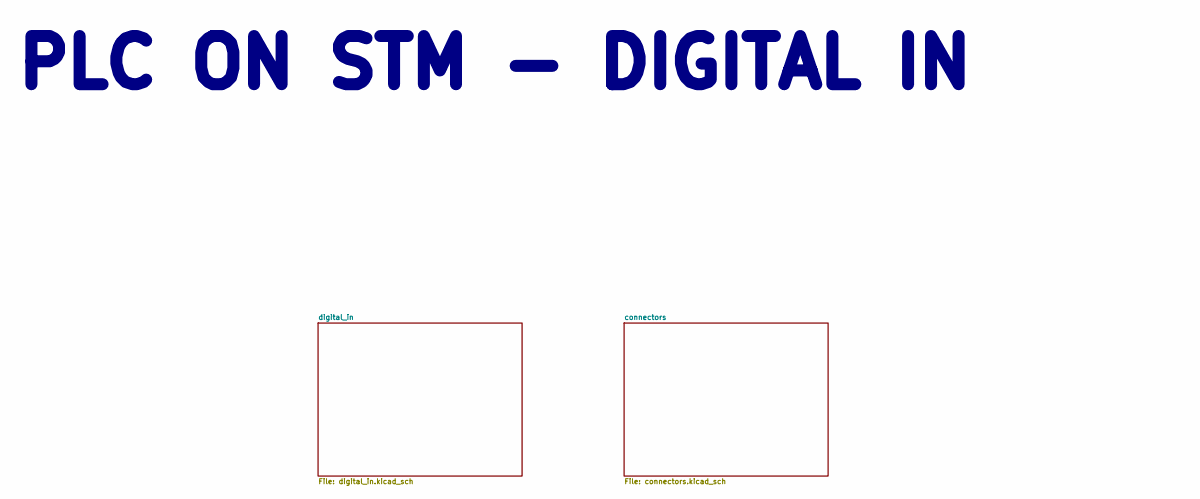
[picture p15: schematic digital_input.kicad_sch, PLC on STM - Digital Input Shield]

Notes on the sheet:
PLC ON STM - DIGITAL IN

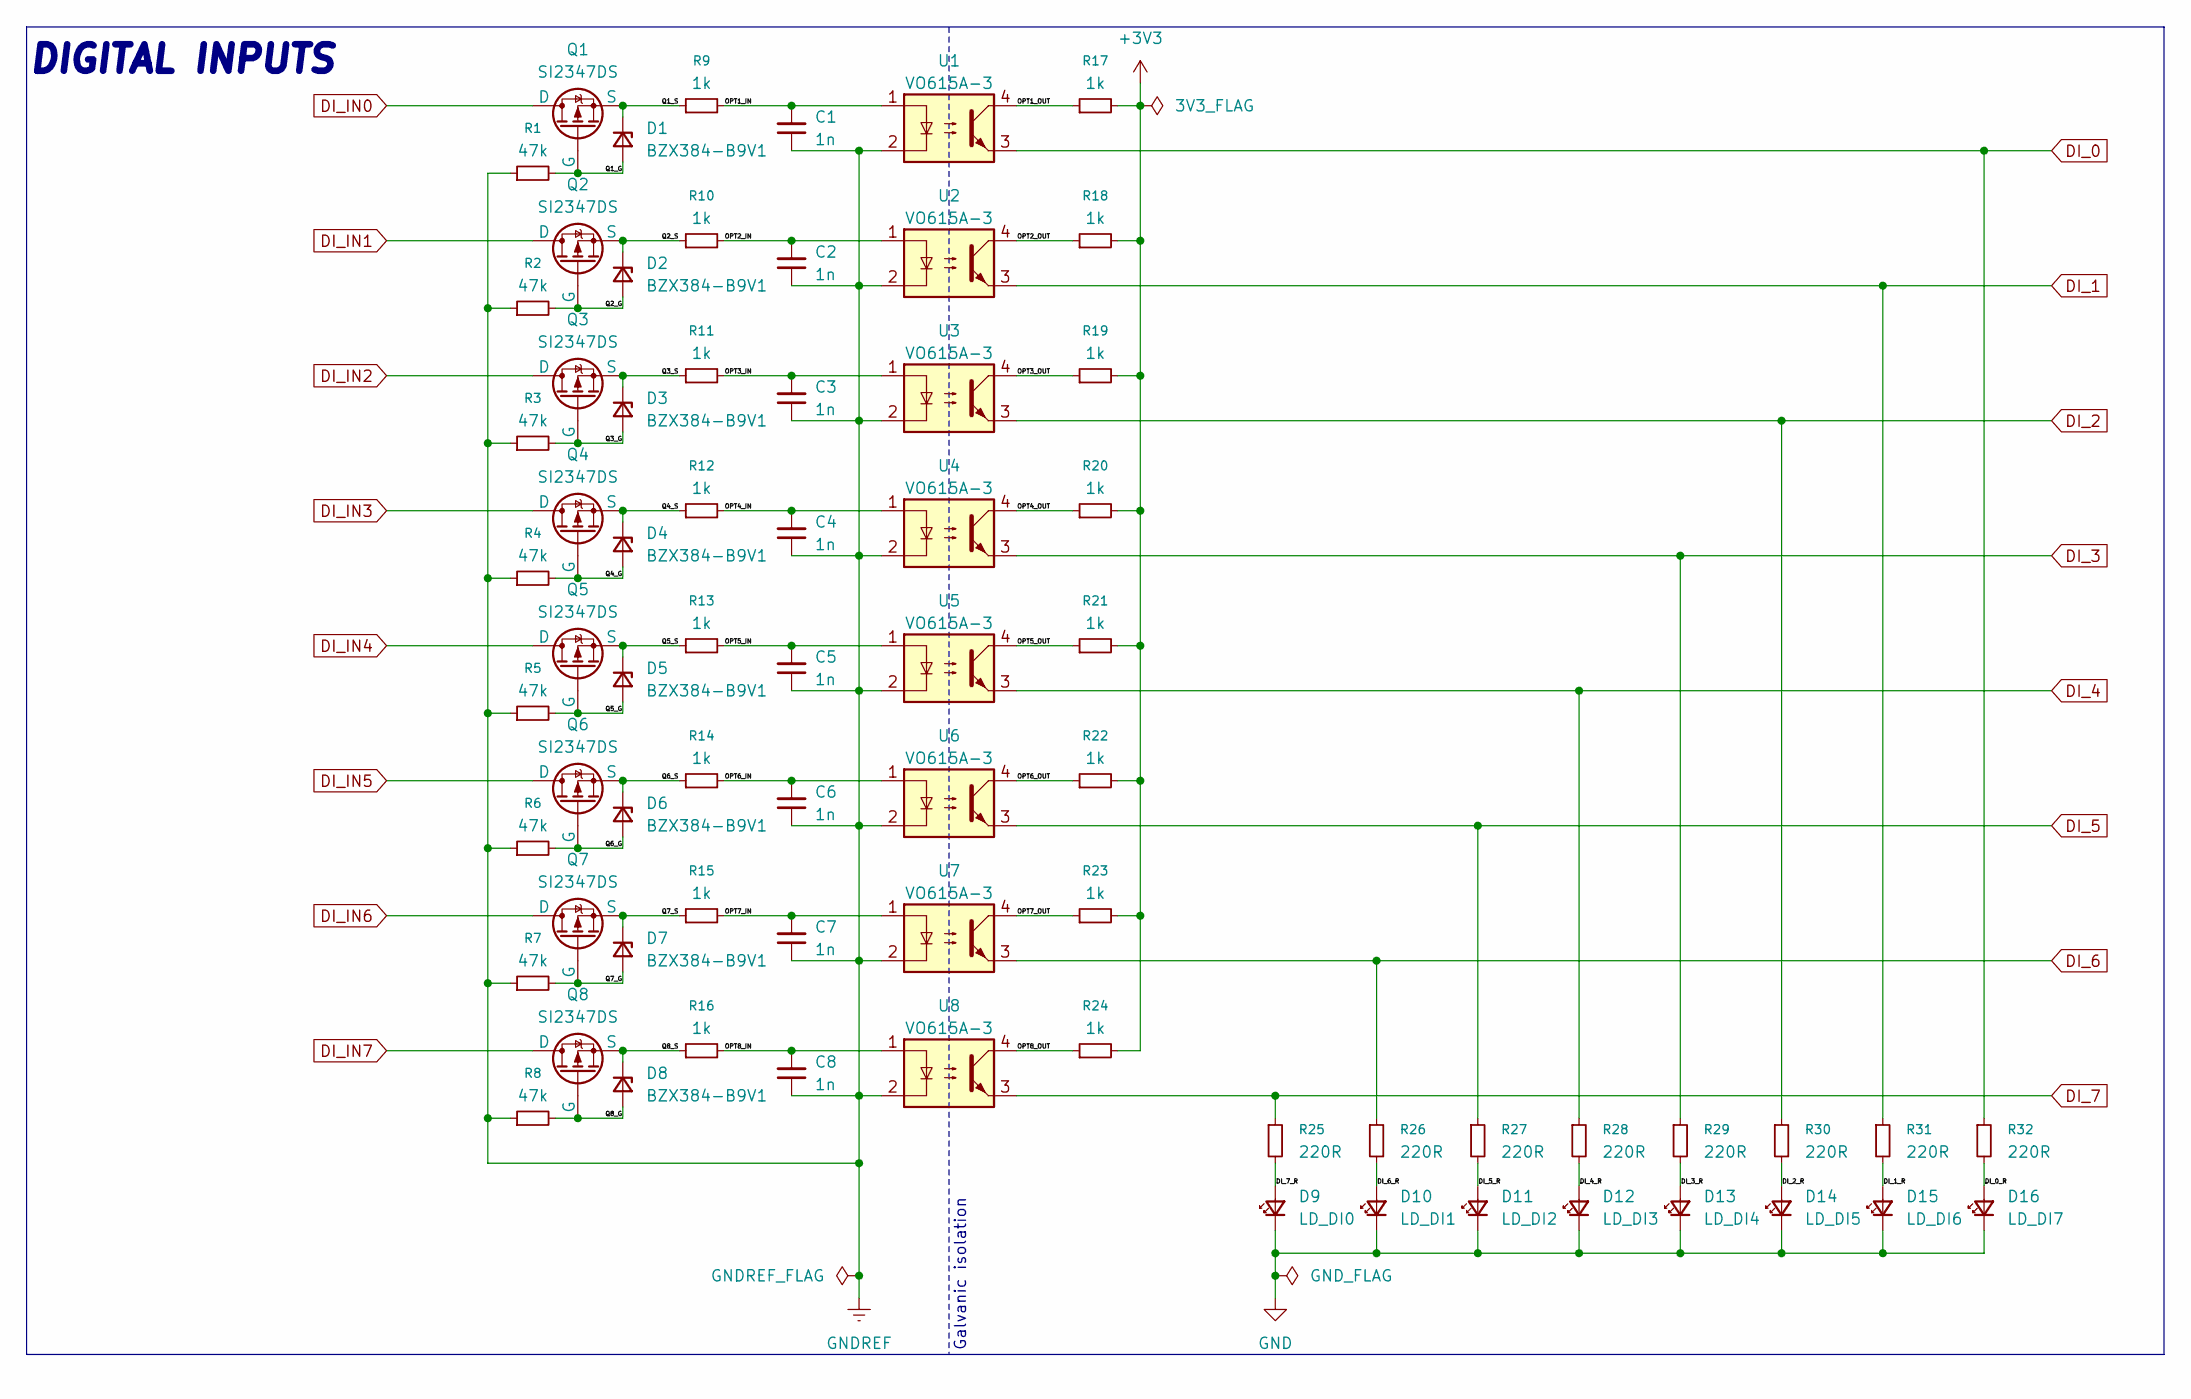
[picture p16: schematic digital_in.kicad_sch, PLC on STM - Digital Input Shield]

Parts:
C1, C2, C3, C4, C5, C6, C7, C8: 1n; C_0603_1608Metric_Pad1.08x0.95mm_HandSolder; Mouser Part Number 81-GRT1885C1E102JA2D
D1, D2, D3, D4, D5, D6, D7, D8: BZX384-B9V1; D_SOD-323_HandSoldering; Mouser Part Number 771-BZX384-B9V1-T/R
D9: LD_DI0; LED_0603_1608Metric_Pad1.05x0.95mm_HandSolder
D10: LD_DI1; LED_0603_1608Metric_Pad1.05x0.95mm_HandSolder
D11: LD_DI2; LED_0603_1608Metric_Pad1.05x0.95mm_HandSolder
D12: LD_DI3; LED_0603_1608Metric_Pad1.05x0.95mm_HandSolder
D13: LD_DI4; LED_0603_1608Metric_Pad1.05x0.95mm_HandSolder
D14: LD_DI5; LED_0603_1608Metric_Pad1.05x0.95mm_HandSolder
D15: LD_DI6; LED_0603_1608Metric_Pad1.05x0.95mm_HandSolder
D16: LD_DI7; LED_0603_1608Metric_Pad1.05x0.95mm_HandSolder
Q1, Q2, Q3, Q4, Q5, Q6, Q7, Q8: SI2347DS; SOT-23-3; Mouser Part Number 78-SI2347DS-T1-GE3
R1, R2, R3, R4, R5, R6, R7, R8: 47k; R_0603_1608Metric_Pad0.98x0.95mm_HandSolder; Mouser Part Number 71-CRCW0603-47K-E3
R9, R10, R11, R12, R13, R14, R15, R16, R17, R18, R19, R20, R21, R22, R23, R24: 1k; R_0603_1608Metric_Pad0.98x0.95mm_HandSolder; Mouser Part Number 71-CRCW06031K00FKED
R25, R26, R27, R28, R29, R30, R31, R32: 220R; R_0603_1608Metric_Pad0.98x0.95mm_HandSolder; Mouser Part Number 71-CRCW0603220RFKEAH
U1, U2, U3, U4, U5, U6, U7, U8: VO615A-3; DIP-4_W8.89mm_SMDSocket_LongPads

Connections:
+3V3: R17.2, R18.2, R19.2, R20.2, R21.2, R22.2, R23.2, R24.2; also elsewhere on the board
/digital_in/DI_0_R: D16.2 (A), R32.2
/digital_in/DI_1_R: D15.2 (A), R31.2
/digital_in/DI_2_R: D14.2 (A), R30.2
/digital_in/DI_3_R: D13.2 (A), R29.2
/digital_in/DI_4_R: D12.2 (A), R28.2
/digital_in/DI_5_R: D11.2 (A), R27.2
/digital_in/DI_6_R: D10.2 (A), R26.2
/digital_in/DI_7_R: D9.2 (A), R25.2
/digital_in/OPT1_IN: C1.2, R9.2, U1.1
/digital_in/OPT1_OUT: R17.1, U1.4
/digital_in/OPT2_IN: C2.2, R10.2, U2.1
/digital_in/OPT2_OUT: R18.1, U2.4
/digital_in/OPT3_IN: C3.2, R11.2, U3.1
/digital_in/OPT3_OUT: R19.1, U3.4
/digital_in/OPT4_IN: C4.2, R12.2, U4.1
/digital_in/OPT4_OUT: R20.1, U4.4
/digital_in/OPT5_IN: C5.2, R13.2, U5.1
/digital_in/OPT5_OUT: R21.1, U5.4
/digital_in/OPT6_IN: C6.2, R14.2, U6.1
/digital_in/OPT6_OUT: R22.1, U6.4
/digital_in/OPT7_IN: C7.2, R15.2, U7.1
/digital_in/OPT7_OUT: R23.1, U7.4
/digital_in/OPT8_IN: C8.2, R16.2, U8.1
/digital_in/OPT8_OUT: R24.1, U8.4
/digital_in/Q1_G: D1.2 (A), Q1.2 (G), R1.2
/digital_in/Q1_S: D1.1 (K), Q1.3 (S), R9.1
/digital_in/Q2_G: D2.2 (A), Q2.2 (G), R2.2
/digital_in/Q2_S: D2.1 (K), Q2.3 (S), R10.1
/digital_in/Q3_G: D3.2 (A), Q3.2 (G), R3.2
/digital_in/Q3_S: D3.1 (K), Q3.3 (S), R11.1
/digital_in/Q4_G: D4.2 (A), Q4.2 (G), R4.2
/digital_in/Q4_S: D4.1 (K), Q4.3 (S), R12.1
/digital_in/Q5_G: D5.2 (A), Q5.2 (G), R5.2
/digital_in/Q5_S: D5.1 (K), Q5.3 (S), R13.1
/digital_in/Q6_G: D6.2 (A), Q6.2 (G), R6.2
/digital_in/Q6_S: D6.1 (K), Q6.3 (S), R14.1
/digital_in/Q7_G: D7.2 (A), Q7.2 (G), R7.2
/digital_in/Q7_S: D7.1 (K), Q7.3 (S), R15.1
/digital_in/Q8_G: D8.2 (A), Q8.2 (G), R8.2
/digital_in/Q8_S: D8.1 (K), Q8.3 (S), R16.1
DI_0: R32.1, U1.3; also elsewhere on the board
DI_1: R31.1, U2.3; also elsewhere on the board
DI_2: R30.1, U3.3; also elsewhere on the board
DI_3: R29.1, U4.3; also elsewhere on the board
DI_4: R28.1, U5.3; also elsewhere on the board
DI_5: R27.1, U6.3; also elsewhere on the board
DI_6: R26.1, U7.3; also elsewhere on the board
DI_7: R25.1, U8.3; also elsewhere on the board
DI_IN0: Q1.1 (D); also elsewhere on the board
DI_IN1: Q2.1 (D); also elsewhere on the board
DI_IN2: Q3.1 (D); also elsewhere on the board
DI_IN3: Q4.1 (D); also elsewhere on the board
DI_IN4: Q5.1 (D); also elsewhere on the board
DI_IN5: Q6.1 (D); also elsewhere on the board
DI_IN6: Q7.1 (D); also elsewhere on the board
DI_IN7: Q8.1 (D); also elsewhere on the board
GND: D9.1 (K), D10.1 (K), D11.1 (K), D12.1 (K), D13.1 (K), D14.1 (K), D15.1 (K), D16.1 (K); also elsewhere on the board
GNDREF: C1.1, C2.1, C3.1, C4.1, C5.1, C6.1, C7.1, C8.1, R1.1, R2.1, R3.1, R4.1, R5.1, R6.1, R7.1, R8.1, U1.2, U2.2, U3.2, U4.2, U5.2, U6.2, U7.2, U8.2; also elsewhere on the board

Notes on the sheet:
DIGITAL INPUTS
Galvanic isolation

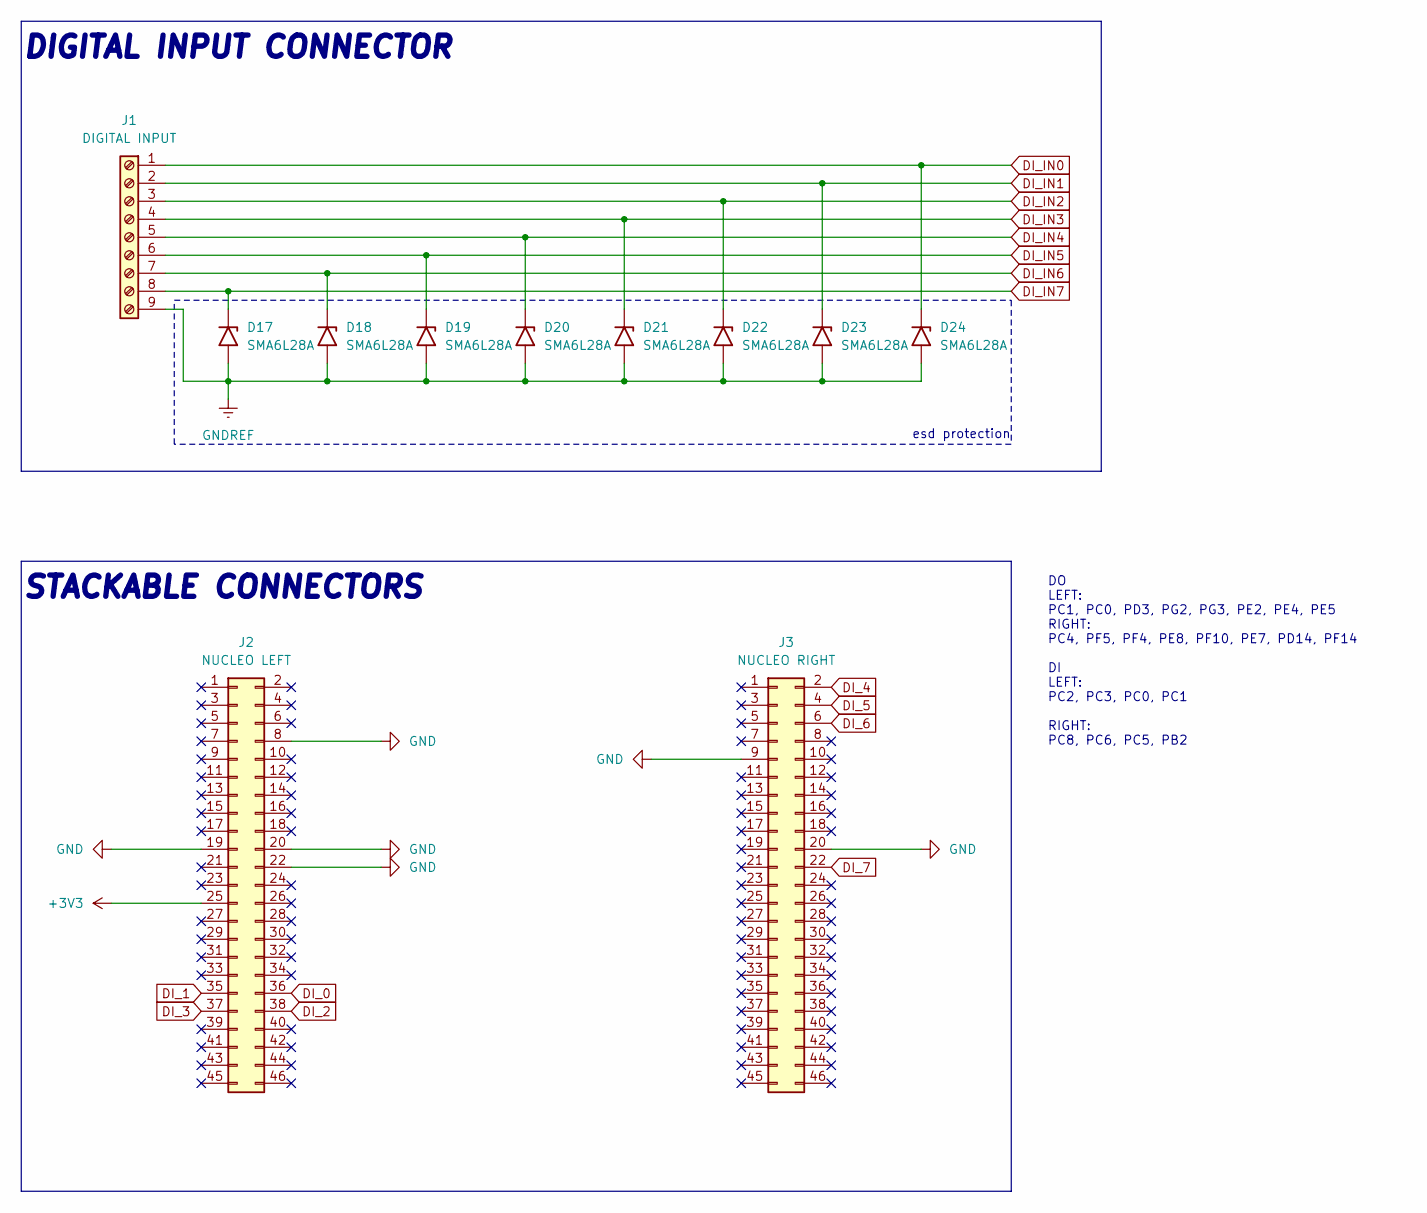
[picture p17: schematic connectors.kicad_sch, PLC on STM - Digital Input Shield]

Parts:
D17, D18, D19, D20, D21, D22, D23, D24: SMA6L28A; D_SMA; Mouser Part Number 576-SMA6L28A
J1: DIGITAL INPUT; 1725724; Mouser Part Number 651-1725724
J2: NUCLEO LEFT; PRT12790; Mouser Part Number 474-PRT-12790
J3: NUCLEO RIGHT; PRT12790; Mouser Part Number 474-PRT-12790

Connections:
+3V3: J2.25; also elsewhere on the board
DI_0: J2.36; also elsewhere on the board
DI_1: J2.35; also elsewhere on the board
DI_2: J2.38; also elsewhere on the board
DI_3: J2.37; also elsewhere on the board
DI_4: J3.2; also elsewhere on the board
DI_5: J3.4; also elsewhere on the board
DI_6: J3.6; also elsewhere on the board
DI_7: J3.22; also elsewhere on the board
DI_IN0: D24.1 (A1), J1.1; also elsewhere on the board
DI_IN1: D23.1 (A1), J1.2; also elsewhere on the board
DI_IN2: D22.1 (A1), J1.3; also elsewhere on the board
DI_IN3: D21.1 (A1), J1.4; also elsewhere on the board
DI_IN4: D20.1 (A1), J1.5; also elsewhere on the board
DI_IN5: D19.1 (A1), J1.6; also elsewhere on the board
DI_IN6: D18.1 (A1), J1.7; also elsewhere on the board
DI_IN7: D17.1 (A1), J1.8; also elsewhere on the board
GND: J2.8, J2.19, J2.20, J2.22, J3.9, J3.20; also elsewhere on the board
GNDREF: D17.2 (A2), D18.2 (A2), D19.2 (A2), D20.2 (A2), D21.2 (A2), D22.2 (A2), D23.2 (A2), D24.2 (A2), J1.9; also elsewhere on the board

Notes on the sheet:
STACKABLE CONNECTORS
DIGITAL INPUT CONNECTOR
esd protection
DO LEFT: PC1, PC0, PD3, PG2, PG3, PE2, PE4, PE5 RIGHT: PC4, PF5, PF4, PE8, PF10, PE7, PD14, PF14 DI LEFT: PC2, PC3, PC0, PC1 RIGHT: PC8, PC6, PC5, PB2

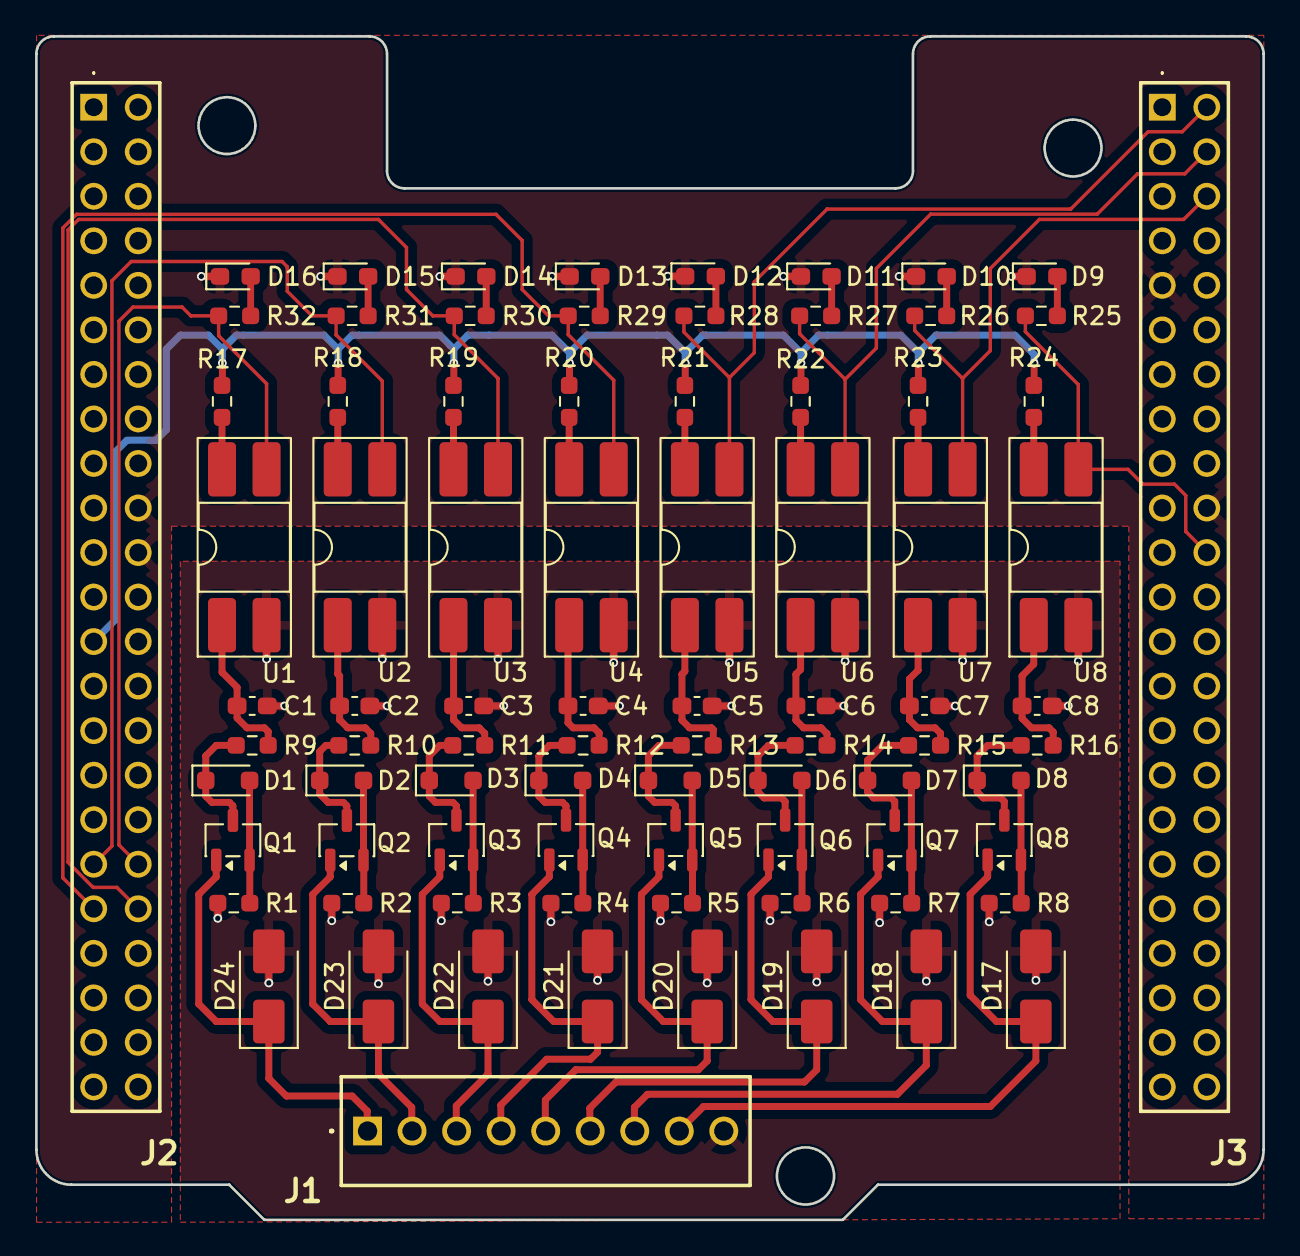
[picture p18: board digital_input.kicad_pcb from above]

Board: 4 copper layers, 70.0 x 67.5 mm, 83 parts (0 on the bottom side), 59 nets.
