POTOK22/STM32-PLC/Hardware/DigitalOutput/digital_output.kicad_pcb

## KiCad design Hardware/DigitalOutput/digital_output.kicad_pcb (2026-01-13)

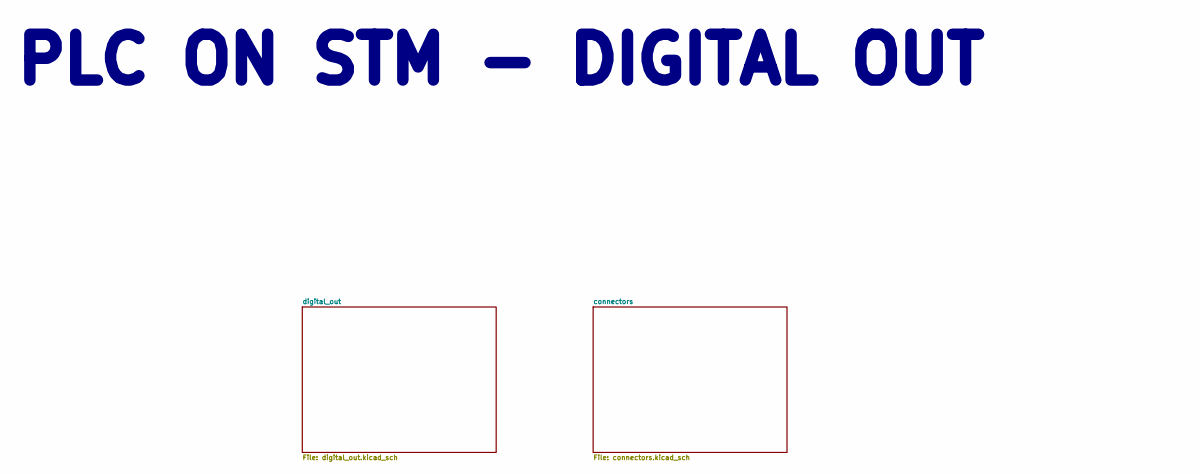
[picture p19: schematic digital_output.kicad_sch, PLC on STM - Digital Output Shield]

Notes on the sheet:
PLC ON STM - DIGITAL OUT

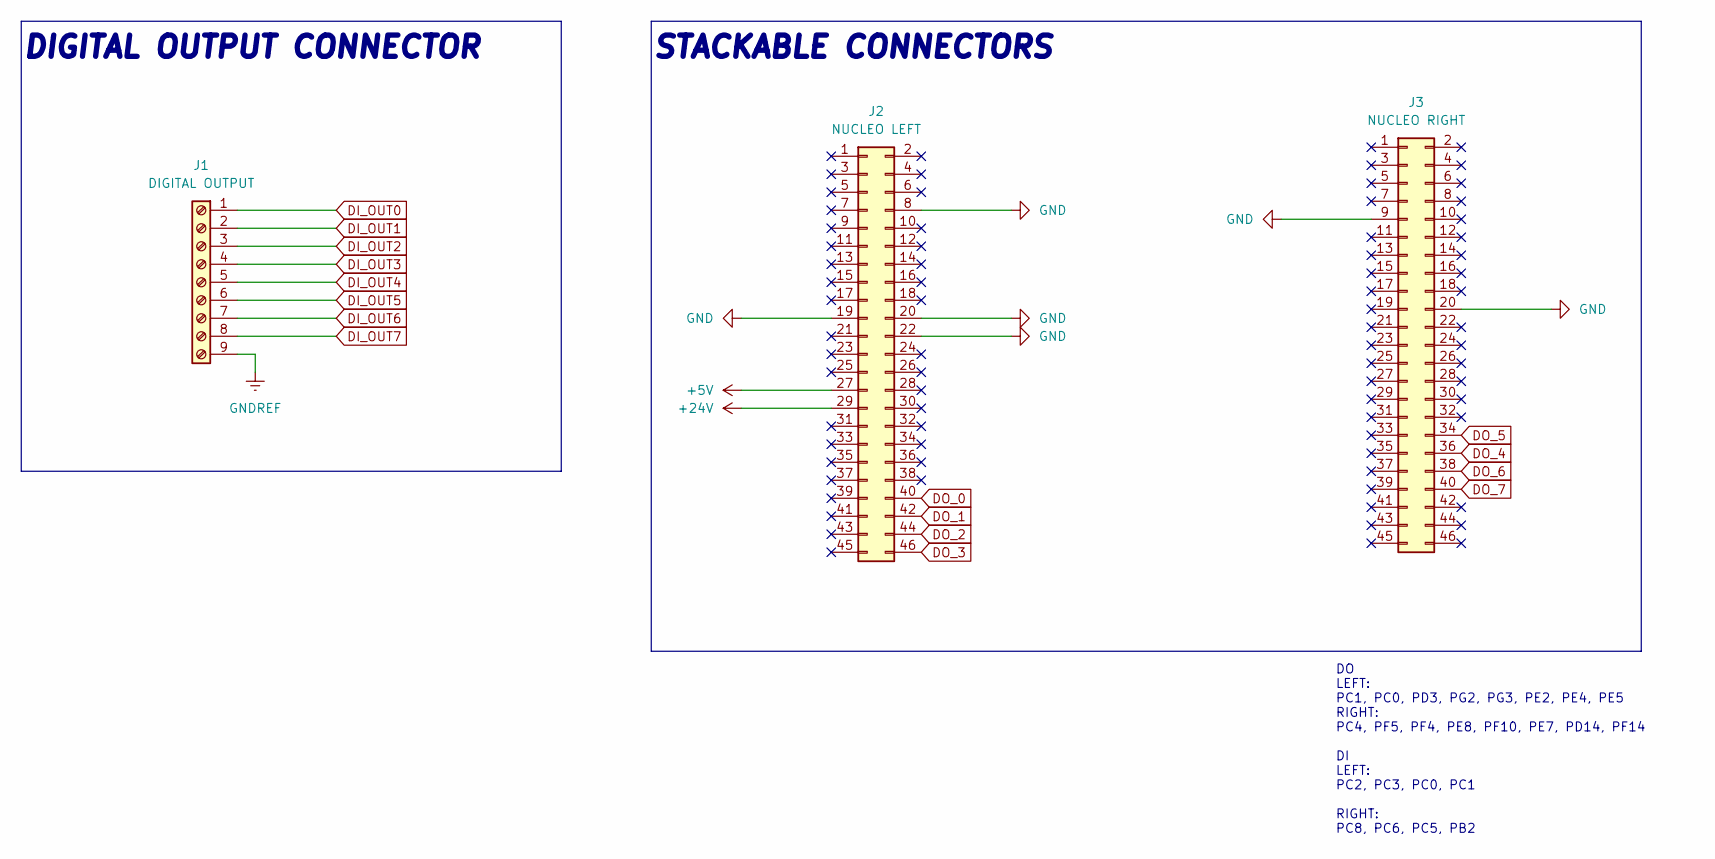
[picture p20: schematic connectors.kicad_sch, PLC on STM - Digital Output Shield]

Parts:
J1: DIGITAL OUTPUT; 1725724; Mouser Part Number 651-1725724
J2: NUCLEO LEFT; PRT12790; Mouser Part Number 474-PRT-12790
J3: NUCLEO RIGHT; PRT12790; Mouser Part Number 474-PRT-12790

Connections:
+5V: J2.27; also elsewhere on the board
+24V: J2.29; also elsewhere on the board
DI_OUT0: J1.1; also elsewhere on the board
DI_OUT1: J1.2; also elsewhere on the board
DI_OUT2: J1.3; also elsewhere on the board
DI_OUT3: J1.4; also elsewhere on the board
DI_OUT4: J1.5; also elsewhere on the board
DI_OUT5: J1.6; also elsewhere on the board
DI_OUT6: J1.7; also elsewhere on the board
DI_OUT7: J1.8; also elsewhere on the board
DO_0: J2.40; also elsewhere on the board
DO_1: J2.42; also elsewhere on the board
DO_2: J2.44; also elsewhere on the board
DO_3: J2.46; also elsewhere on the board
DO_4: J3.36; also elsewhere on the board
DO_5: J3.34; also elsewhere on the board
DO_6: J3.38; also elsewhere on the board
DO_7: J3.40; also elsewhere on the board
GND: J2.8, J2.19, J2.20, J2.22, J3.9, J3.20; also elsewhere on the board
GNDREF: J1.9; also elsewhere on the board

Notes on the sheet:
DO LEFT: PC1, PC0, PD3, PG2, PG3, PE2, PE4, PE5 RIGHT: PC4, PF5, PF4, PE8, PF10, PE7, PD14, PF14 DI LEFT: PC2, PC3, PC0, PC1 RIGHT: PC8, PC6, PC5, PB2
DIGITAL OUTPUT CONNECTOR
STACKABLE CONNECTORS

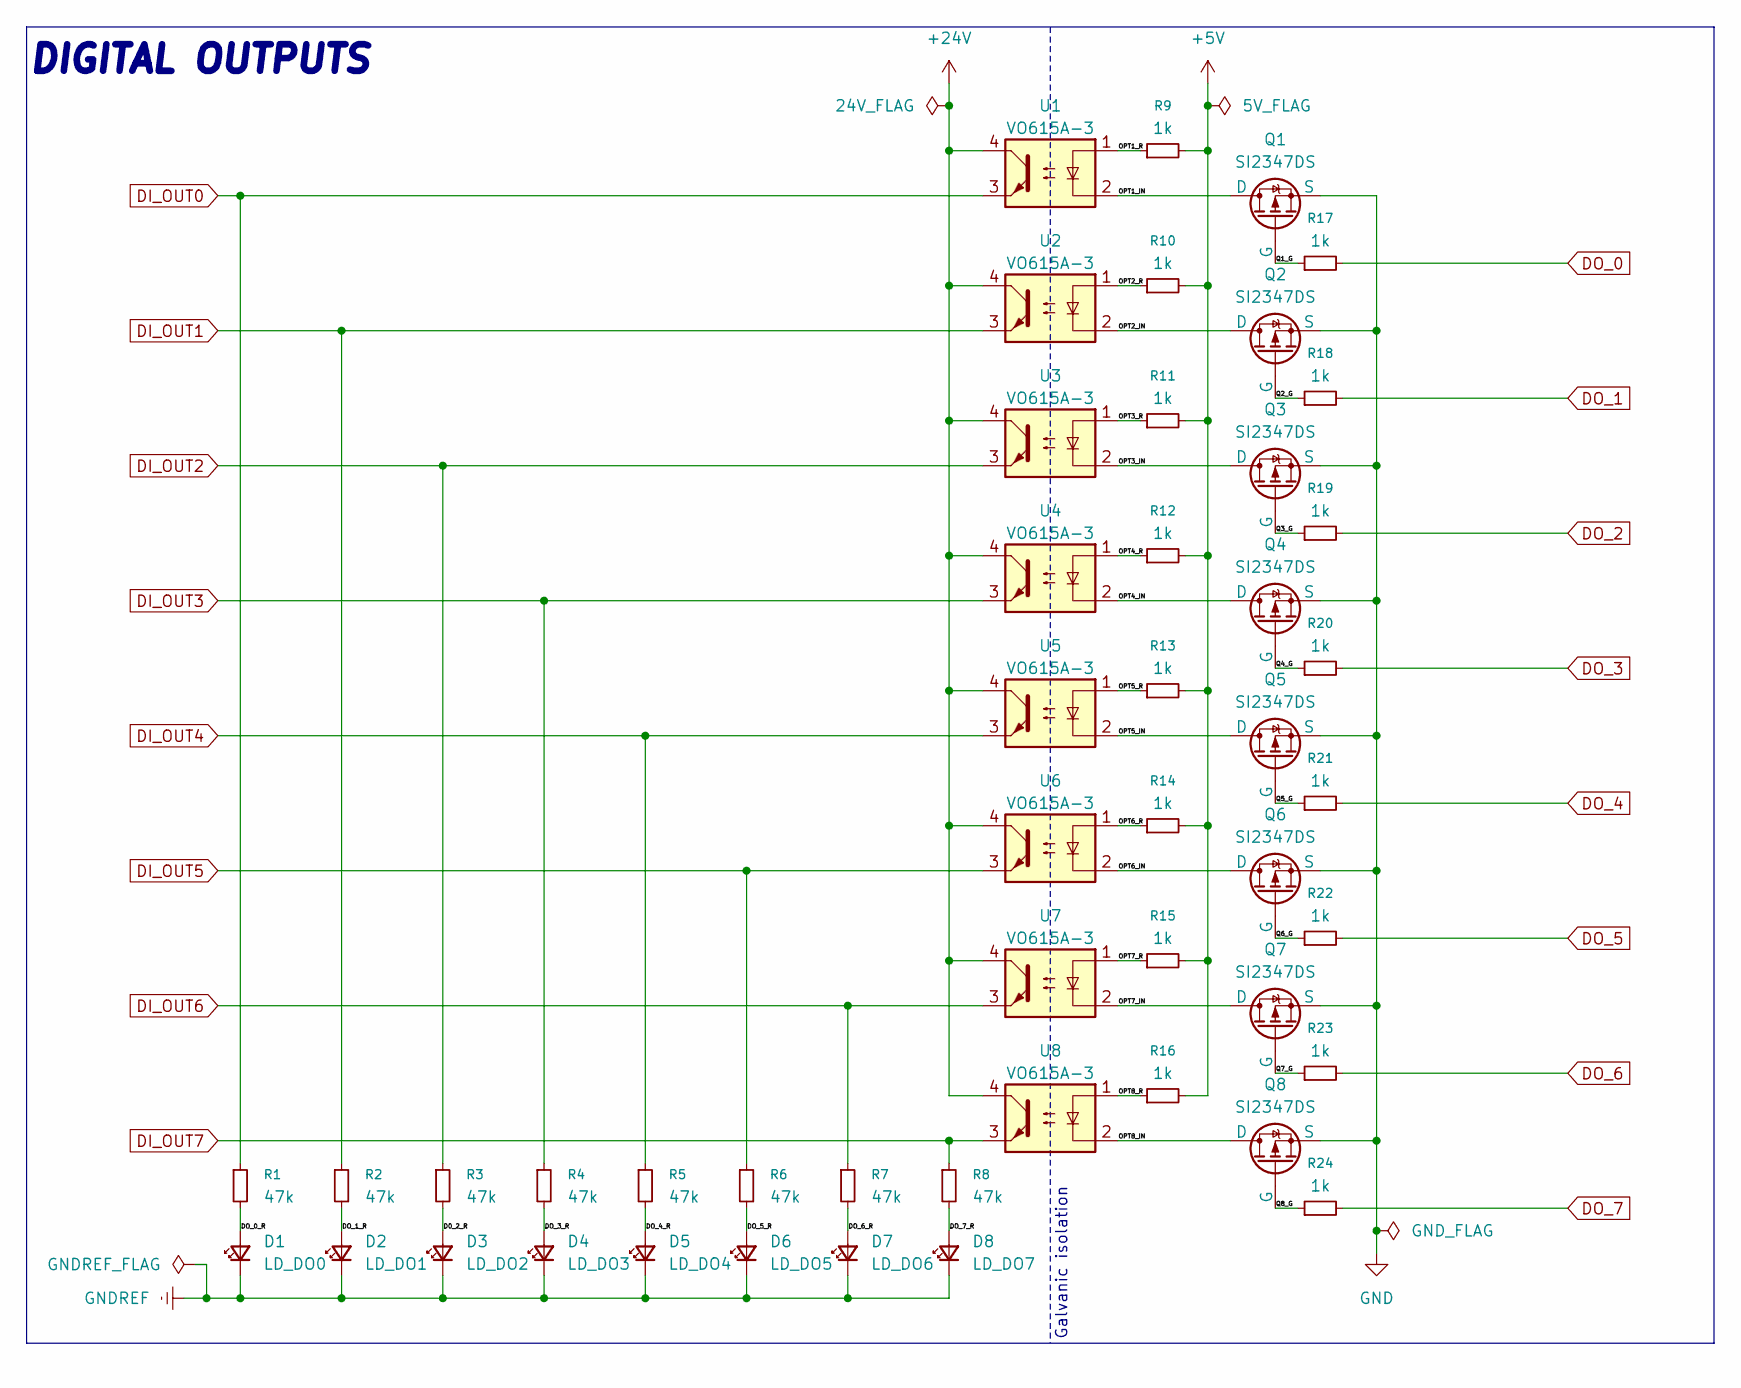
[picture p21: schematic digital_out.kicad_sch, PLC on STM - Digital Output Shield]

Parts:
D1: LD_DO0; LED_0603_1608Metric_Pad1.05x0.95mm_HandSolder
D2: LD_DO1; LED_0603_1608Metric_Pad1.05x0.95mm_HandSolder
D3: LD_DO2; LED_0603_1608Metric_Pad1.05x0.95mm_HandSolder
D4: LD_DO3; LED_0603_1608Metric_Pad1.05x0.95mm_HandSolder
D5: LD_DO4; LED_0603_1608Metric_Pad1.05x0.95mm_HandSolder
D6: LD_DO5; LED_0603_1608Metric_Pad1.05x0.95mm_HandSolder
D7: LD_DO6; LED_0603_1608Metric_Pad1.05x0.95mm_HandSolder
D8: LD_DO7; LED_0603_1608Metric_Pad1.05x0.95mm_HandSolder
Q1, Q2, Q3, Q4, Q5, Q6, Q7, Q8: SI2347DS; SOT-23-3; Mouser Part Number 78-SI2347DS-T1-GE3
R1, R2, R3, R4, R5, R6, R7, R8: 47k; R_0603_1608Metric_Pad0.98x0.95mm_HandSolder; Mouser Part Number 71-CRCW0603-47K-E3
R9, R10, R11, R12, R13, R14, R15, R16, R17, R18, R19, R20, R21, R22, R23, R24: 1k; R_0603_1608Metric_Pad0.98x0.95mm_HandSolder; Mouser Part Number 71-CRCW06031K00FKED
U1, U2, U3, U4, U5, U6, U7, U8: VO615A-3; DIP-4_W8.89mm_SMDSocket_LongPads

Connections:
+5V: R9.2, R10.2, R11.2, R12.2, R13.2, R14.2, R15.2, R16.2; also elsewhere on the board
+24V: U1.4, U2.4, U3.4, U4.4, U5.4, U6.4, U7.4, U8.4; also elsewhere on the board
/digital_out/D0_2_R: D3.2 (A), R3.2
/digital_out/DO_0_R: D1.2 (A), R1.2
/digital_out/DO_1_R: D2.2 (A), R2.2
/digital_out/DO_3_R: D4.2 (A), R4.2
/digital_out/DO_4_R: D5.2 (A), R5.2
/digital_out/DO_5_R: D6.2 (A), R6.2
/digital_out/DO_6_R: D7.2 (A), R7.2
/digital_out/DO_7_R: D8.2 (A), R8.2
/digital_out/OPT1_IN: Q1.1 (D), U1.2
/digital_out/OPT1_R: R9.1, U1.1
/digital_out/OPT2_IN: Q2.1 (D), U2.2
/digital_out/OPT2_R: R10.1, U2.1
/digital_out/OPT3_IN: Q3.1 (D), U3.2
/digital_out/OPT3_R: R11.1, U3.1
/digital_out/OPT4_IN: Q4.1 (D), U4.2
/digital_out/OPT4_R: R12.1, U4.1
/digital_out/OPT5_IN: Q5.1 (D), U5.2
/digital_out/OPT5_R: R13.1, U5.1
/digital_out/OPT6_IN: Q6.1 (D), U6.2
/digital_out/OPT6_R: R14.1, U6.1
/digital_out/OPT7_IN: Q7.1 (D), U7.2
/digital_out/OPT7_R: R15.1, U7.1
/digital_out/OPT8_IN: Q8.1 (D), U8.2
/digital_out/OPT8_R: R16.1, U8.1
/digital_out/Q1_G: Q1.2 (G), R17.1
/digital_out/Q2_G: Q2.2 (G), R18.1
/digital_out/Q3_G: Q3.2 (G), R19.1
/digital_out/Q4_G: Q4.2 (G), R20.1
/digital_out/Q5_G: Q5.2 (G), R21.1
/digital_out/Q6_G: Q6.2 (G), R22.1
/digital_out/Q7_G: Q7.2 (G), R23.1
/digital_out/Q8_G: Q8.2 (G), R24.1
DI_OUT0: R1.1, U1.3; also elsewhere on the board
DI_OUT1: R2.1, U2.3; also elsewhere on the board
DI_OUT2: R3.1, U3.3; also elsewhere on the board
DI_OUT3: R4.1, U4.3; also elsewhere on the board
DI_OUT4: R5.1, U5.3; also elsewhere on the board
DI_OUT5: R6.1, U6.3; also elsewhere on the board
DI_OUT6: R7.1, U7.3; also elsewhere on the board
DI_OUT7: R8.1, U8.3; also elsewhere on the board
DO_0: R17.2; also elsewhere on the board
DO_1: R18.2; also elsewhere on the board
DO_2: R19.2; also elsewhere on the board
DO_3: R20.2; also elsewhere on the board
DO_4: R21.2; also elsewhere on the board
DO_5: R22.2; also elsewhere on the board
DO_6: R23.2; also elsewhere on the board
DO_7: R24.2; also elsewhere on the board
GND: Q1.3 (S), Q2.3 (S), Q3.3 (S), Q4.3 (S), Q5.3 (S), Q6.3 (S), Q7.3 (S), Q8.3 (S); also elsewhere on the board
GNDREF: D1.1 (K), D2.1 (K), D3.1 (K), D4.1 (K), D5.1 (K), D6.1 (K), D7.1 (K), D8.1 (K); also elsewhere on the board

Notes on the sheet:
Galvanic isolation
DIGITAL OUTPUTS

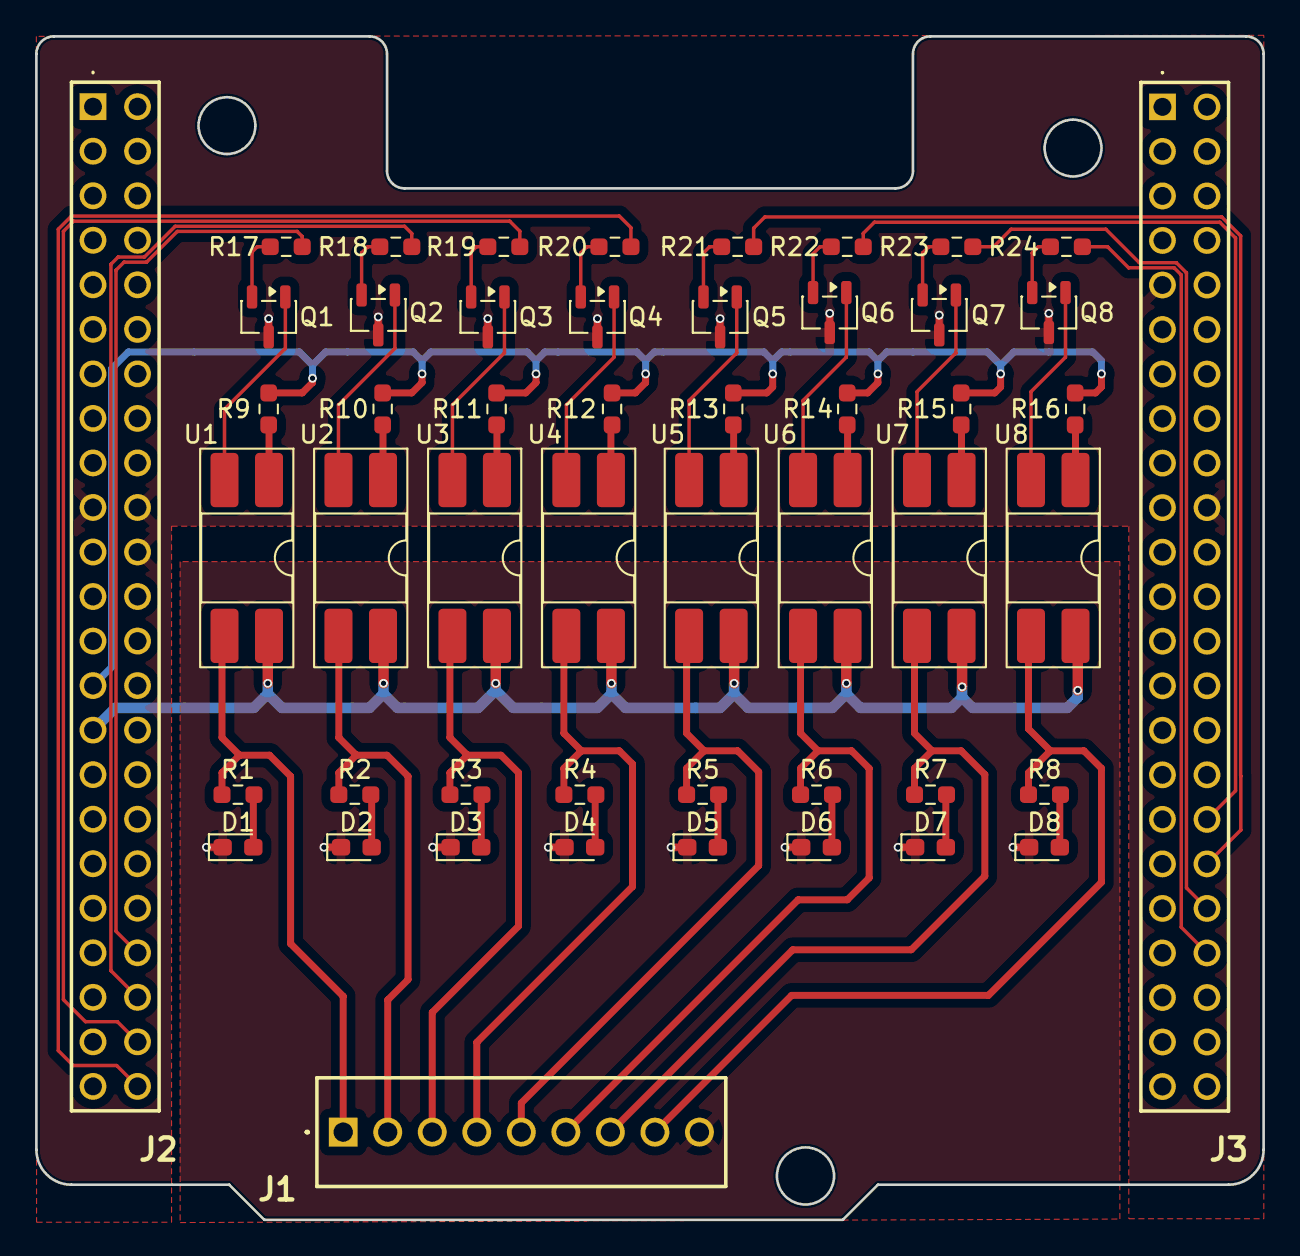
[picture p22: board digital_output.kicad_pcb from above]

Board: 4 copper layers, 70.0 x 67.5 mm, 51 parts (0 on the bottom side), 52 nets.
