POTOK22/STM32-PLC/(commit log)

2025-11-18 schematic added
    [analog_inputs.kicad_sch, analog_outputs.kicad_sch, can.kicad_sch, control.kicad_sch, digital_inputs.kicad_sch, digital_outputs.kicad_sch, power.kicad_sch, stm32-plc.kicad_sch]
2025-11-27 scheme update
    [analog_inputs.kicad_sch, analog_outputs.kicad_sch, can.kicad_sch, connectors.kicad_sch, digital_inputs.kicad_sch, digital_outputs.kicad_sch, power.kicad_sch, stm32-plc.kicad_sch]
2025-12-26 schematic update
    [ISO7721FQDWVRQ1.stp, WBBOMDesignTPS563200DDCR.csv, WBBOMDesignTPS563300DRLR.csv, analog_inputs.kicad_sch, analog_outputs.kicad_sch, can.kicad_sch, connectors.kicad_sch, digital_inputs.kicad_sch]
2025-12-27 hardware update - module shield division
    [analogIO.kicad_pcb, analogIO.kicad_sch, analog_input.kicad_sch, analog_inputs.kicad_sch, analog_output.kicad_sch, analog_outputs.kicad_sch, can.kicad_sch, can_uart.kicad_pcb]
2025-12-27 .gitignore update
    [connectors.kicad_sch, power.kicad_pcb]
2025-12-28 schematic update - all pcbs
    [analog_input.kicad_sch, analog_output.kicad_sch, connectors.kicad_sch, digitalIO.kicad_sch, digital_input.kicad_sch, digital_output.kicad_sch]
2025-12-29 schematic update - digital and analog footprints added
    [analogIO.kicad_pcb, analog_input.kicad_sch, analog_output.kicad_sch, connectors.kicad_sch, digitalIO.kicad_pcb, digital_input.kicad_sch, digital_output.kicad_sch]
2026-01-05 schematic update & pcb update
    [WBBOMDesignTPS563200DDCR.csv, WBBOMDesignTPS563300DRLR.csv, connectors.kicad_sch, power.kicad_pcb, power_section.kicad_sch]
2026-01-09 digital output & digital input update
    [analogIO.kicad_pcb, connectors.kicad_sch, digitalIO.kicad_pcb, digitalIO.kicad_sch, digital_in.kicad_sch, digital_input.kicad_pcb, digital_input.kicad_sch, digital_out.kicad_sch]
2026-01-10 digital input finished
    [connectors.kicad_sch, digital_in.kicad_sch, digital_input.kicad_pcb]
2026-01-11 digital input pins update
    [connectors.kicad_sch, digital_input.kicad_pcb]
2026-01-11 digital input update
    [connectors.kicad_sch]
2026-01-12 digital output & power finished
    [connectors.kicad_sch, digital_input.kicad_pcb, digital_out.kicad_sch, digital_output.kicad_pcb, power.kicad_pcb, power_section.kicad_sch]
2026-01-13 analog & can finished
    [analogIO.kicad_pcb, can.kicad_sch, can_uart.kicad_pcb, can_uart.kicad_sch, connectors.kicad_sch, power.kicad_pcb, uart.kicad_sch]
2026-01-13 small adjustments and final revision
    [analogIO.kicad_pcb, analog_input.kicad_sch, can_uart.kicad_pcb, connectors.kicad_sch, digital_input.kicad_pcb, digital_output.kicad_pcb, power.kicad_pcb]
2026-01-13 gerber files added
    [analogIO-B_Cu.gbl, analogIO-B_Mask.gbs, analogIO-B_Paste.gbp, analogIO-B_Silkscreen.gbo, analogIO-Edge_Cuts.gm1, analogIO-F_Cu.gtl, analogIO-F_Mask.gts, analogIO-F_Paste.gtp]
2026-01-14 small adjustments
    [digital_in.kicad_sch, power_section.kicad_sch]
